Ed-EE-Eng/Graphics_Thermometer/extra/Enclosure_STL/480X320_MEGA_Front_Panel w4_Btn_Pad Rev2.STL

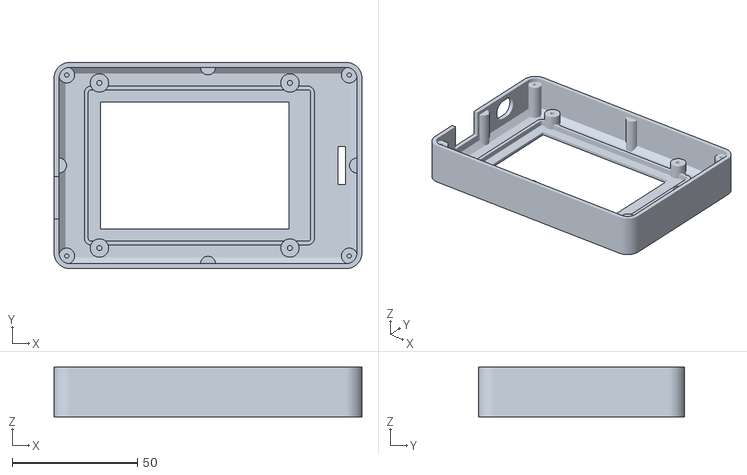
[picture p1: CAD file, 2019-03-07]
extra/Enclosure_STL/480X320_MEGA_Front_Panel w4_Btn_Pad Rev2.STL
123.2 x 82.6 x 19.9
