Ed-EE-Eng/Graphics_Thermometer/extra/Enclosure_STL/480x320_Lcd_TiltStand4_Base (Threaded).STL

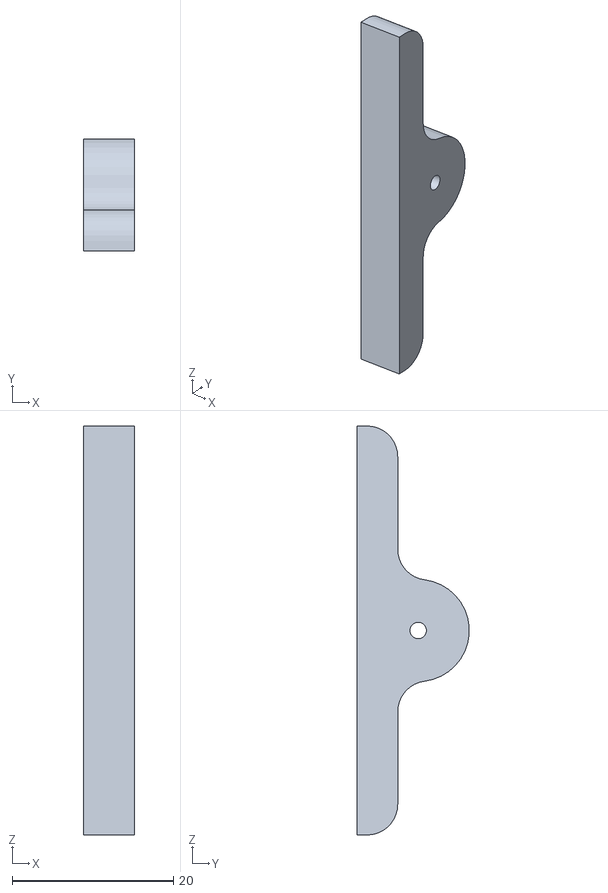
[picture p2: CAD file, 2019-03-04]
extra/Enclosure_STL/480x320_Lcd_TiltStand4_Base (Threaded).STL
6.35 x 13.9 x 50.8
