Ed-EE-Eng/Graphics_Thermometer/extra/Enclosure_STL/MEGA_Backside_Frame.STL

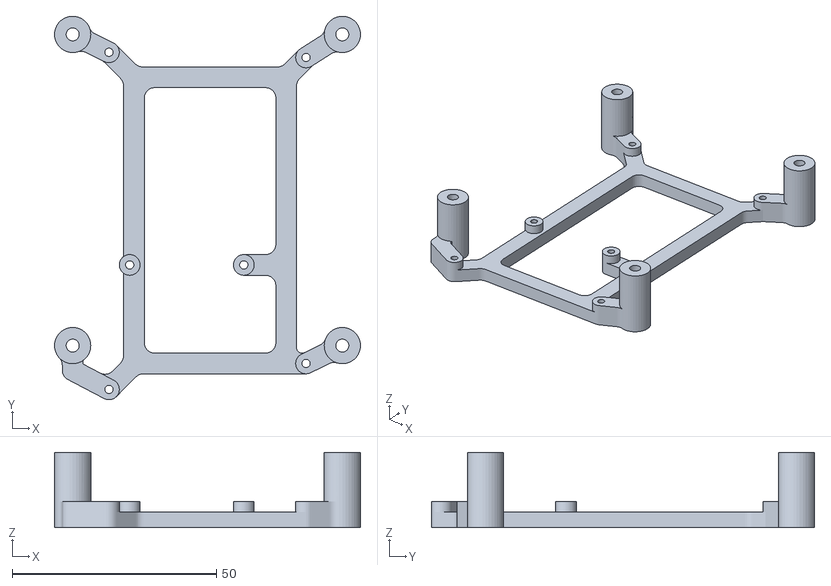
[picture p3: CAD file, 2019-03-04]
extra/Enclosure_STL/MEGA_Backside_Frame.STL
74.9 x 93.9 x 18.4
