Ed-EE-Eng/Graphics_Thermometer/extra/Enclosure_STL/480x320_Lcd_TiltStand2_Mount.STL

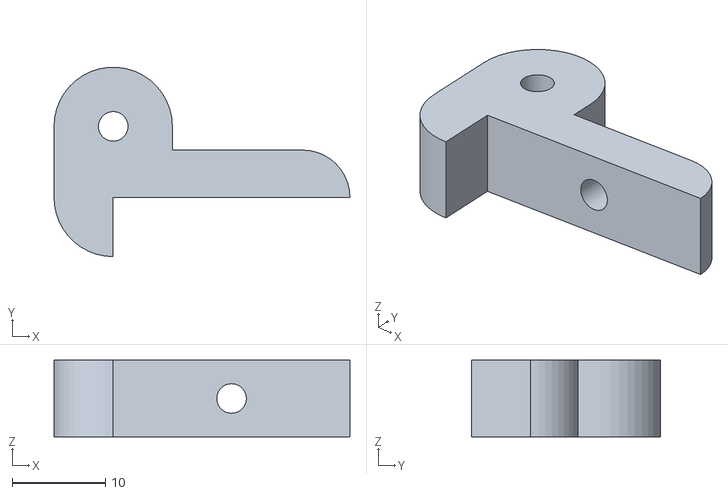
[picture p4: CAD file, 2019-03-04]
extra/Enclosure_STL/480x320_Lcd_TiltStand2_Mount.STL
31.7 x 20.3 x 8.26
