Ed-EE-Eng/Graphics_Thermometer/extra/Enclosure_STL/480x320 MEGA_Rear_Panel_Rev_3.STL

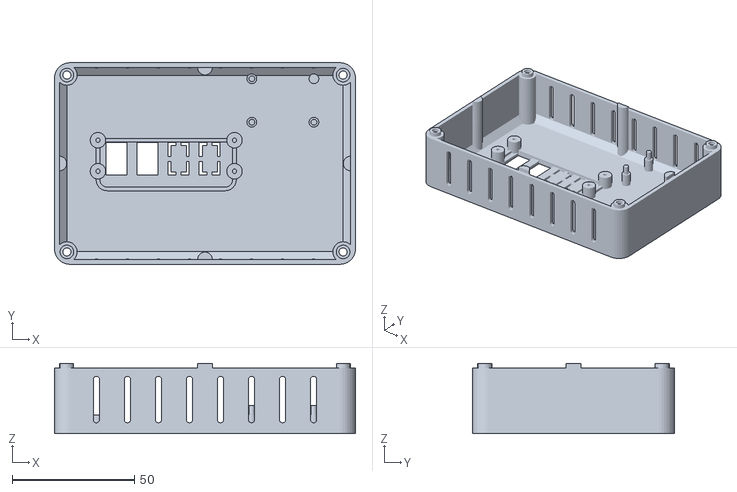
[picture p5: CAD file, 2019-03-04]
extra/Enclosure_STL/480x320 MEGA_Rear_Panel_Rev_3.STL
123.2 x 82.6 x 28.8
