Ed-EE-Eng/Graphics_Thermometer/(list of files, cad)

Other CAD files:
extra/Enclosure_STL/480X320_MEGA_Front_Panel wNo_Btn_Pad Rev2.STL
