Ed-EE-Eng/Graphics_Thermometer/extra/Graphing_Thermometer_Build_&_Design_Notes_Ver3_00.pdf

# Table of Contents

# Graphing Thermometer Project

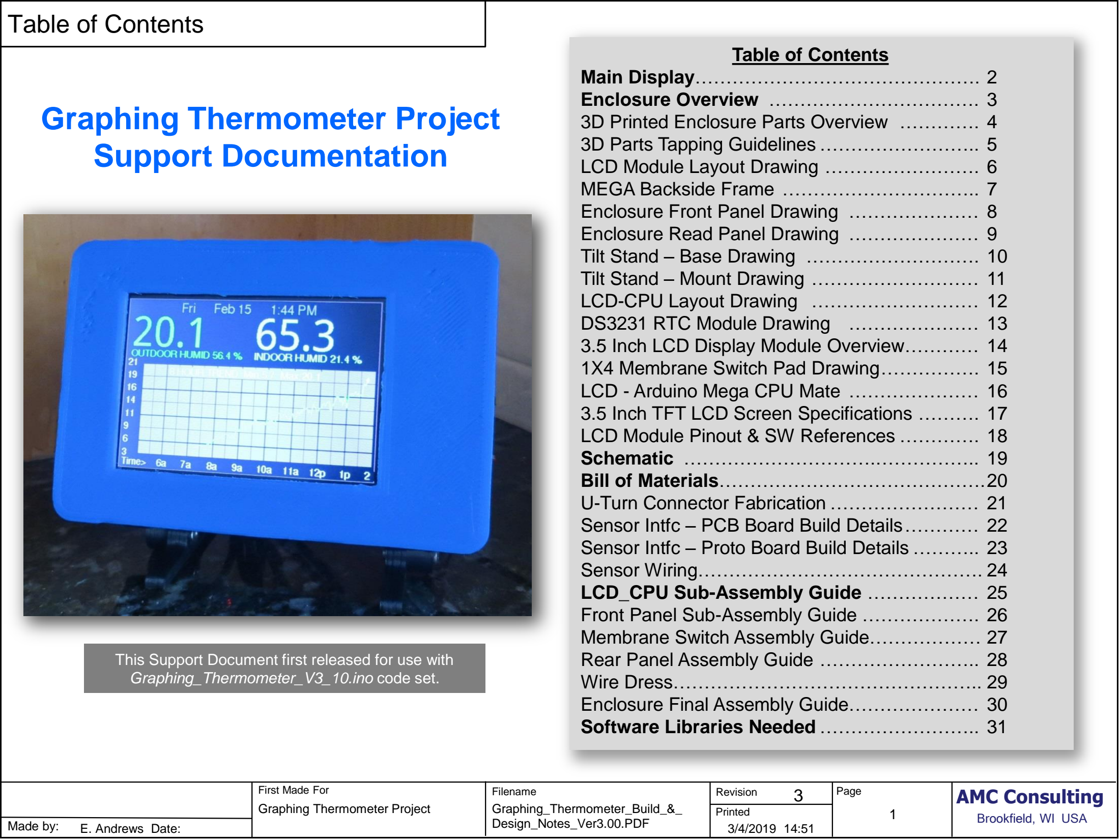
[picture p6: page 1]

Graphing_Thermometer_Build_&_
Design_Notes_Ver3.00.PDF
Filename | Revision | Page

Made by:

| Printed
3/4/2019 14:51

Brookfield, WI USA
E. Andrews Date:

First Made For
Graphing Thermometer Project

# AMC Consulting

# Support Documentation

# Table of Contents

## This Support Document first released for use with

Graphing_Thermometer_V3_10.ino code set.

# Main Display

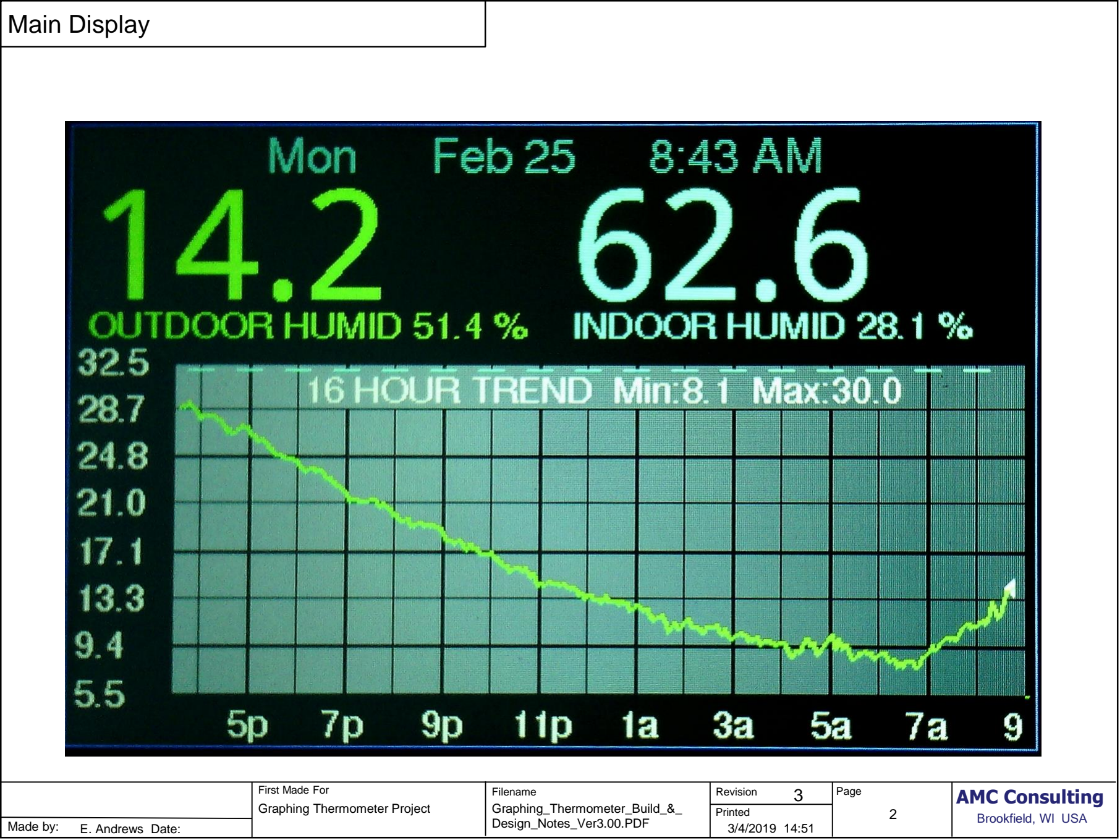
[picture p7: page 2]

# Enclosure Overview

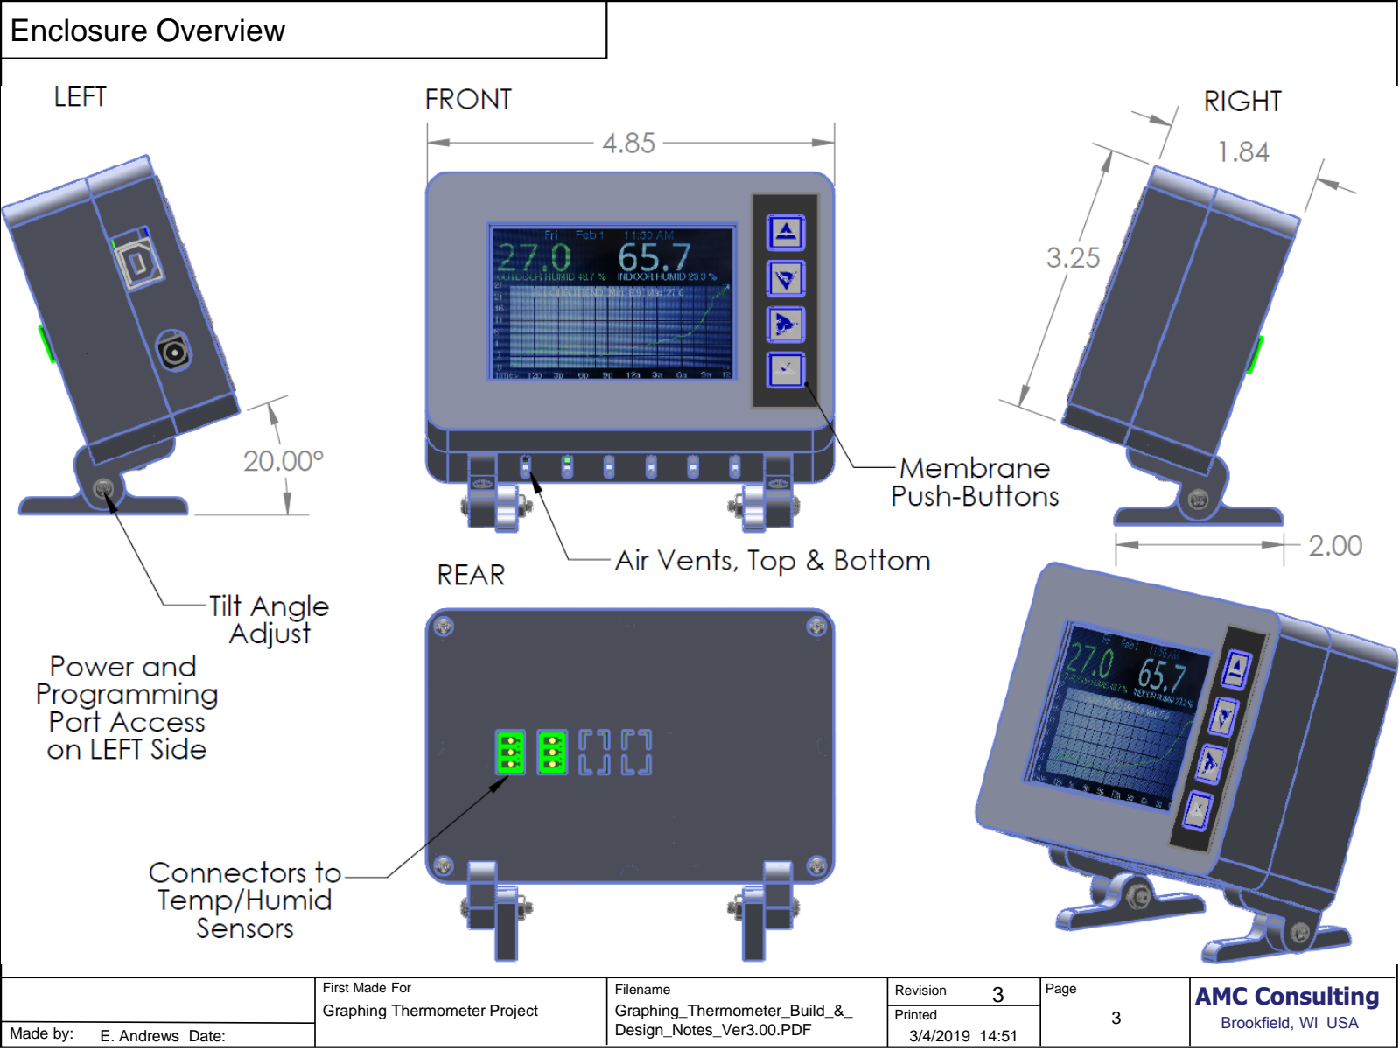
[picture p8: page 3]

# 3D Printed Enclosure Parts Overview

ENCLOSURE | ENCLOSURE-REAR PANEL (Qty: 1) -FRONT PANEL (Qty: 1)

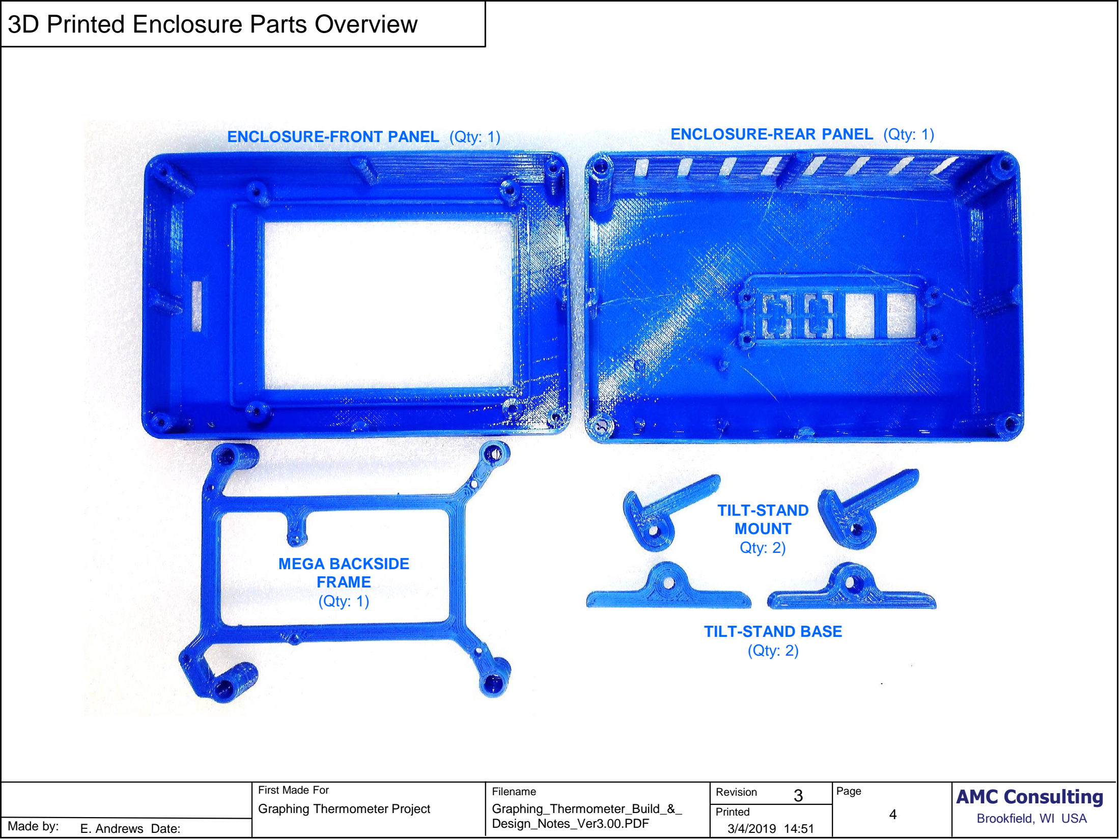
[picture p9: page 4]

## TILT-STAND MOUNT Qty: 2)

## TILT-STAND BASE (Qty: 2)

## MEGA BACKSIDE FRAME (Qty: 1)

# 3D Parts Tapping Guidelines

## TILT-STAND MOUNT

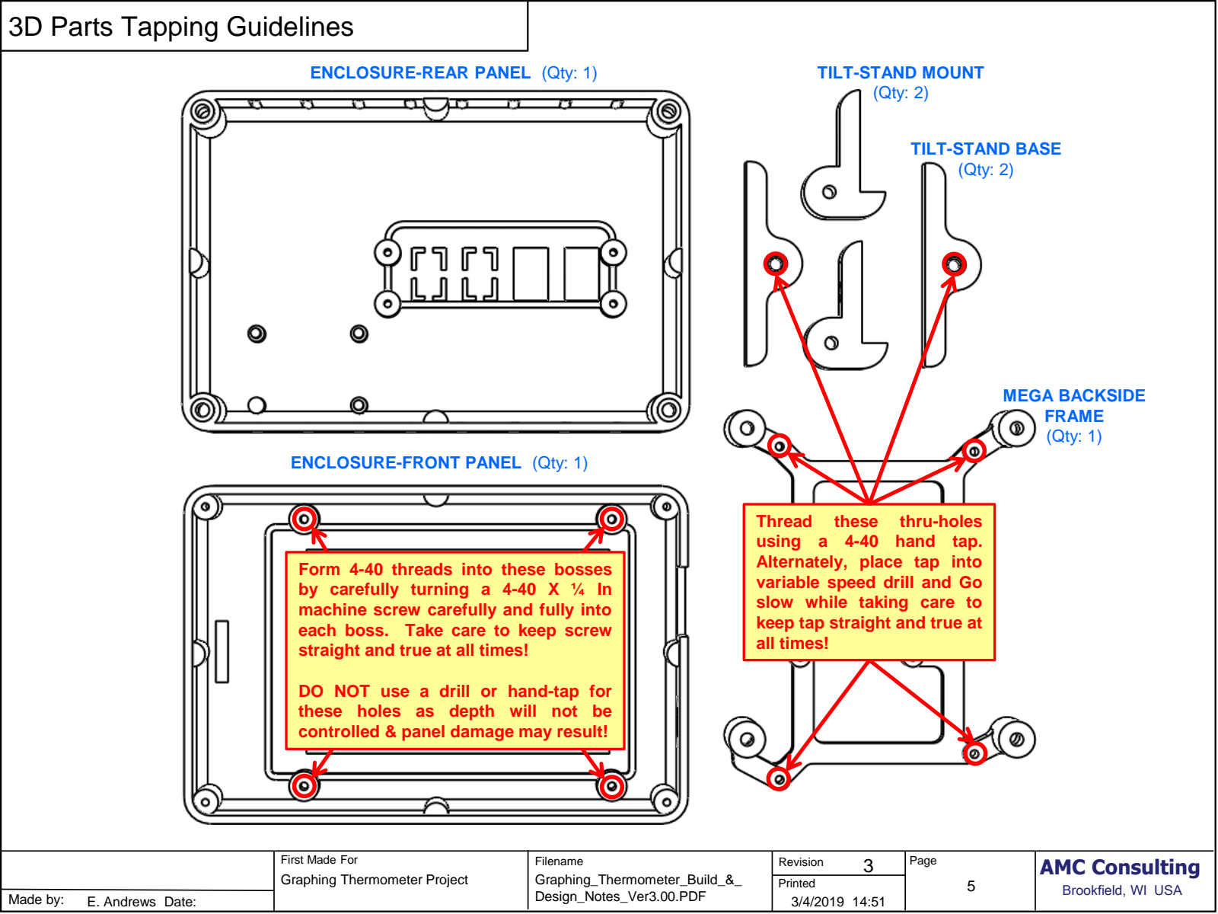
[picture p10: page 5]

Thread | these | thru-holes
using a 4-40 hand tap.

## Alternately, place tap into variable speed drill and Go slow while taking care to keep tap straight and true at all times!

## Form 4-40 threads into these bosses by carefully turning a 4-40 X ¼ In machine screw carefully and fully into each boss. Take care to keep screw straight and true at all times!

## DO NOT use a drill or hand-tap for these holes as depth will not be controlled & panel damage may result!

## (Qty: 2)

## ENCLOSURE-REAR PANEL (Qty: 1)

## ENCLOSURE-FRONT PANEL (Qty: 1)

## TILT-STAND BASE (Qty: 2)

## MEGA BACKSIDE FRAME (Qty: 1)

# LCD Module Layout Drawing 480x320 LCD Module Drawing

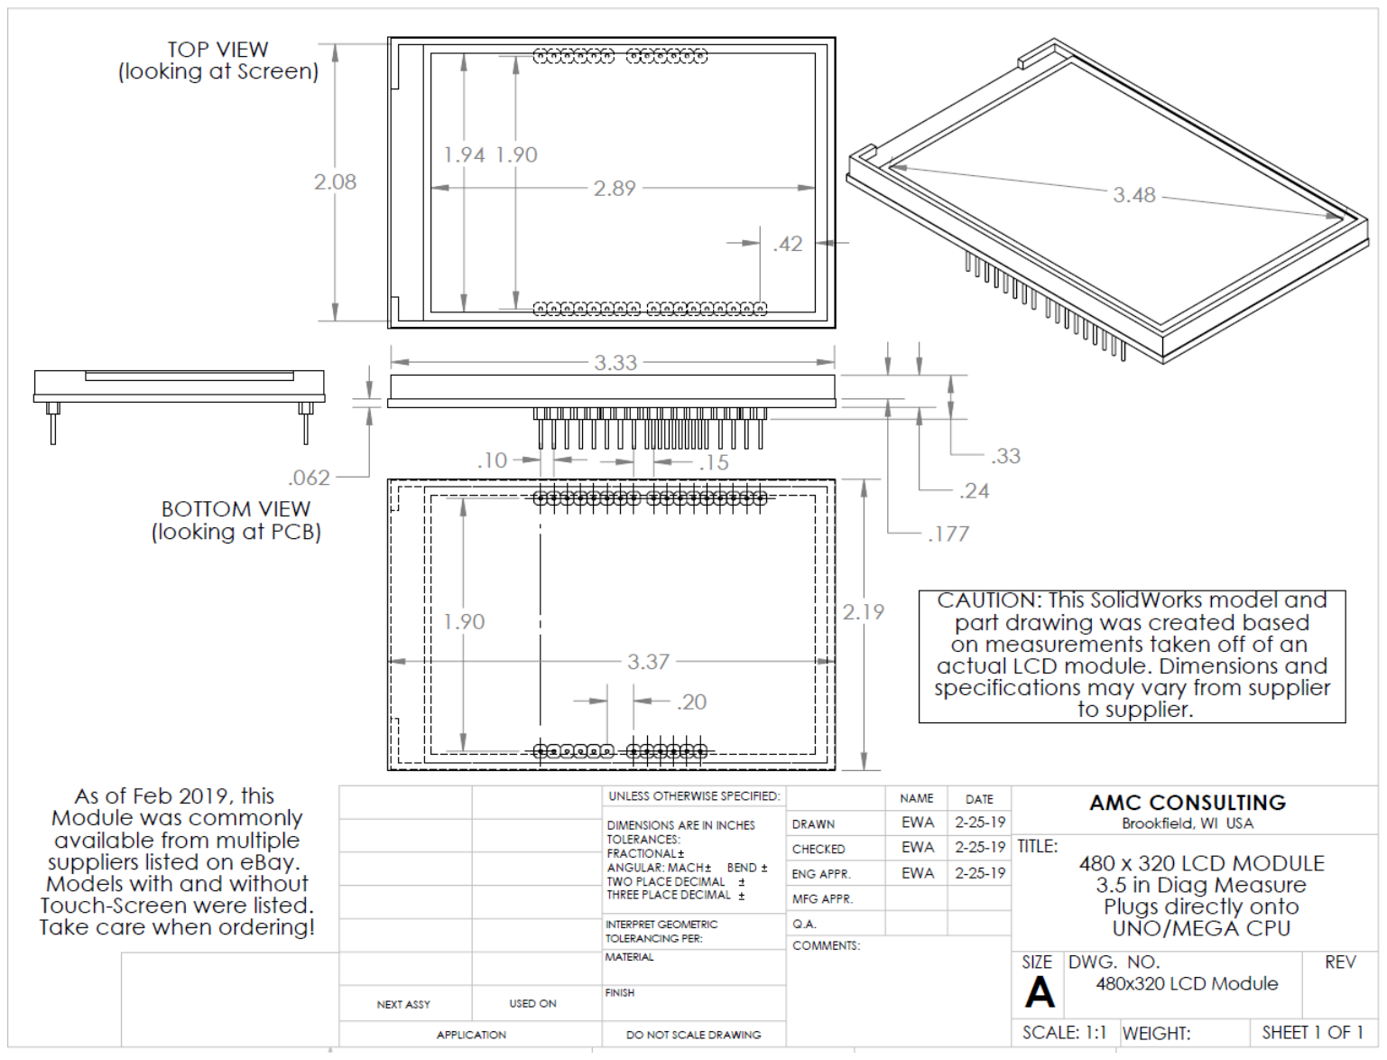
[picture p11: page 6]

# MEGA Backside Frame

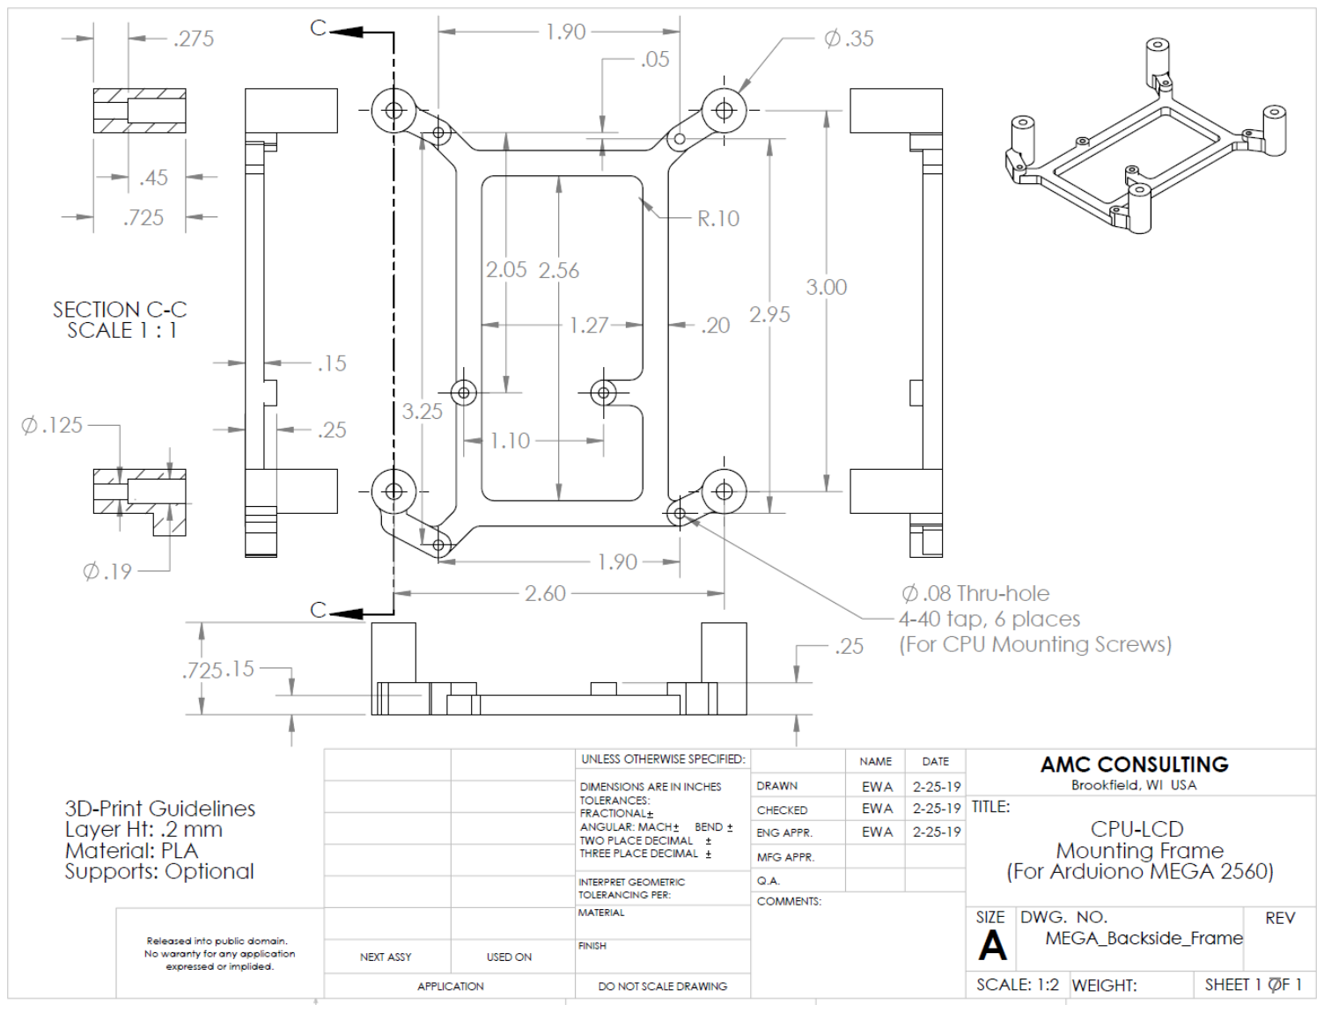
[picture p12: page 7]

# Enclosure Front Panel Drawing Enclosure Front Panel

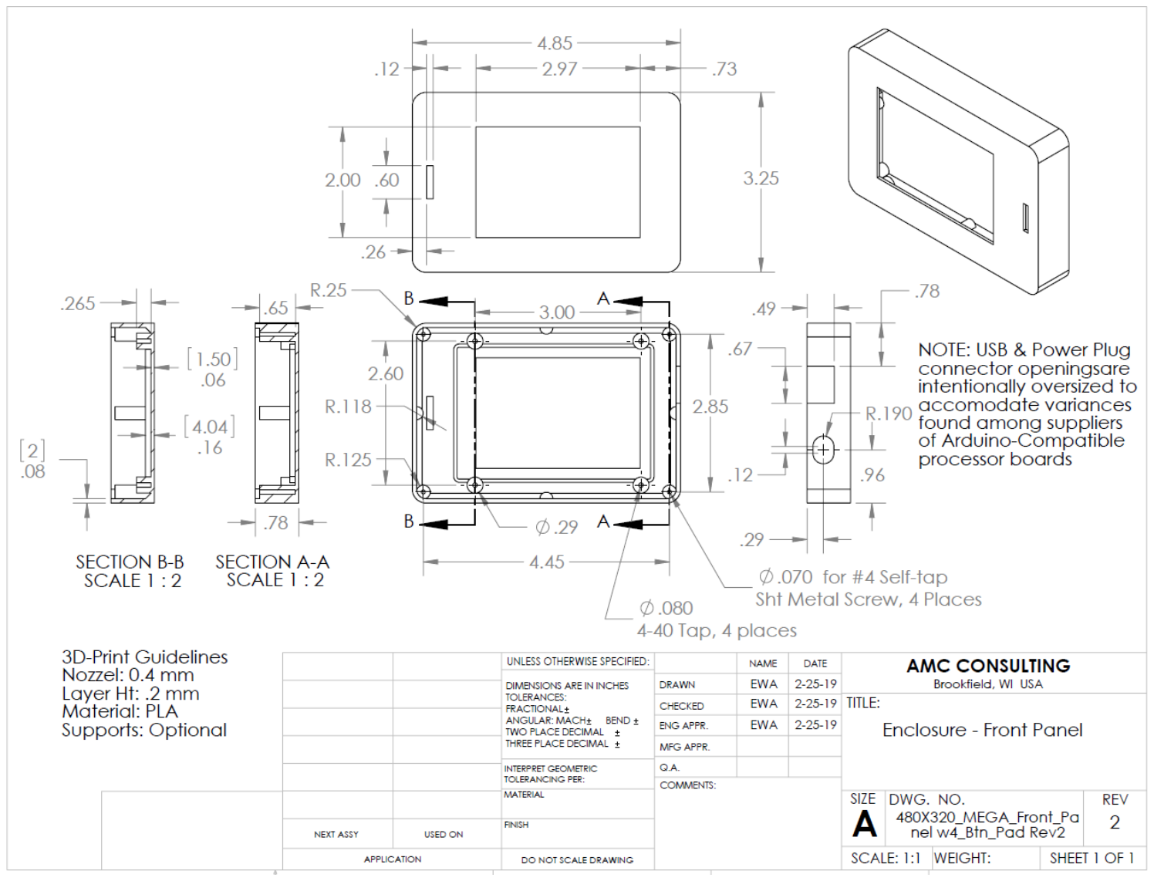
[picture p13: page 8]

# Enclosure Read Panel Drawing Enclosure Rear Panel

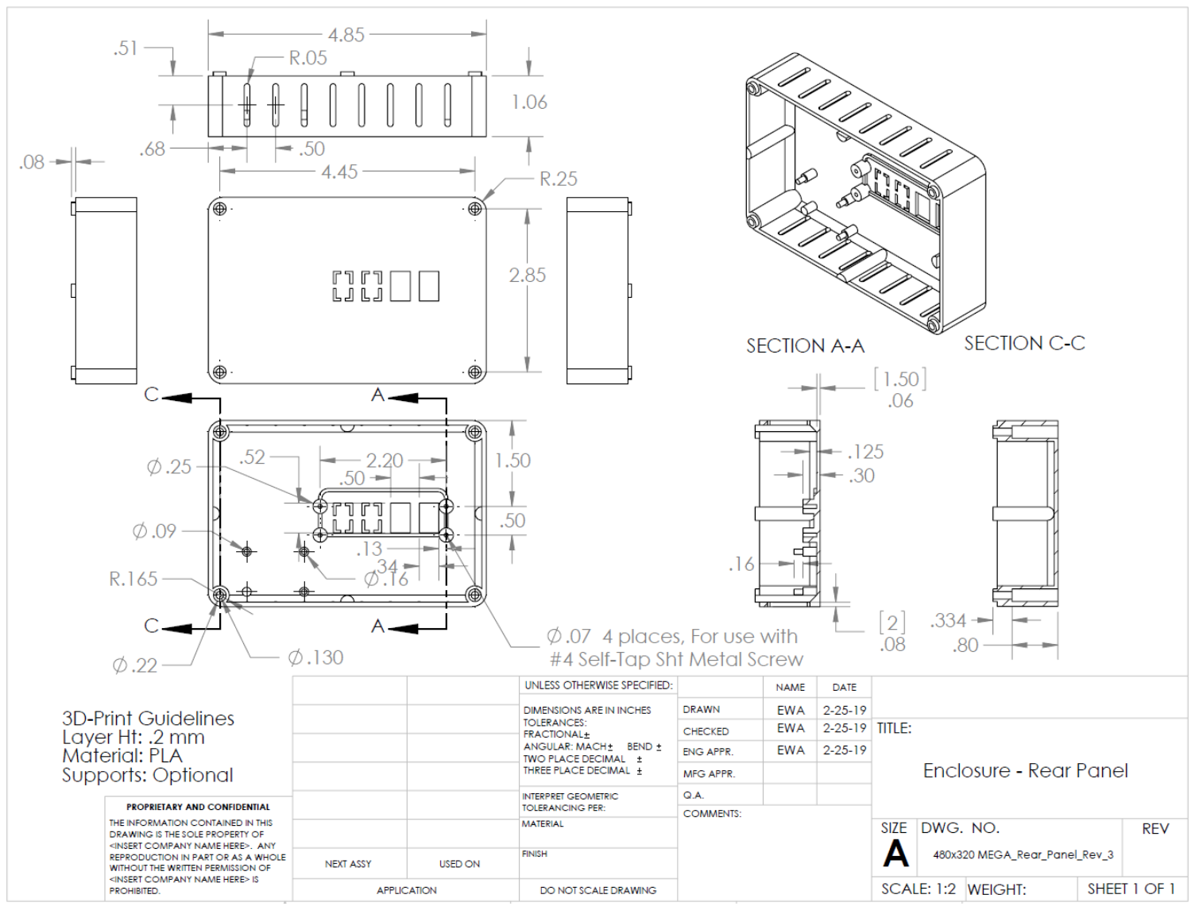
[picture p14: page 9]

# Tilt Stand – Base Drawing TILT STAND BASE

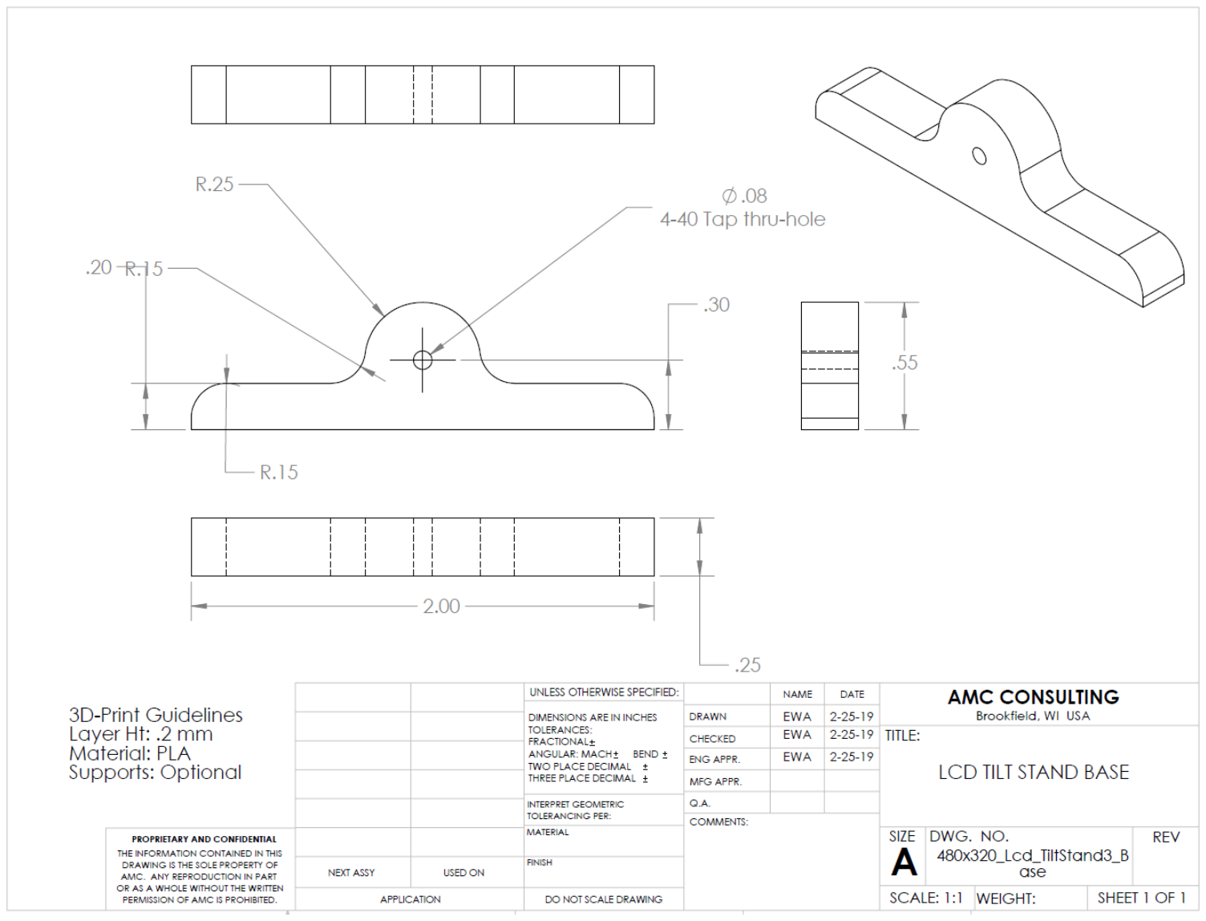
[picture p15: page 10]

# Tilt Stand – Mount Drawing TILT STAND MOUNT

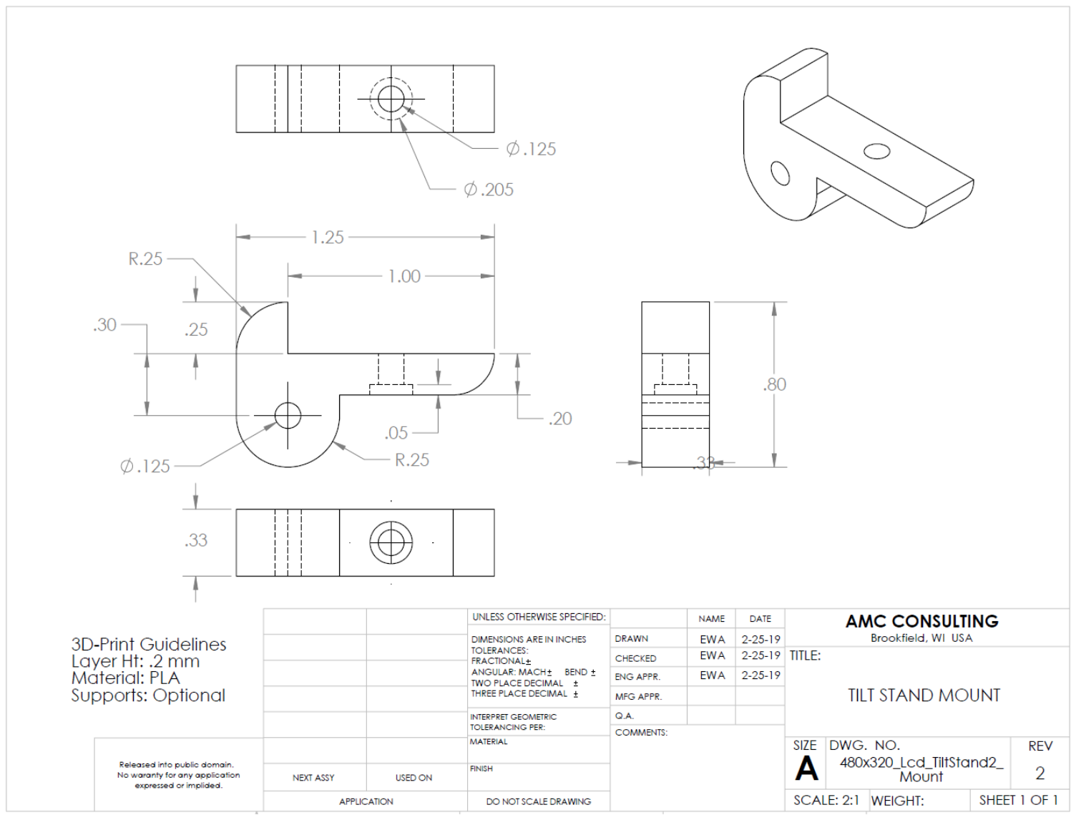
[picture p16: page 11]

# LCD-CPU Layout Drawing LCD-CPU Sub-Assembly Layout

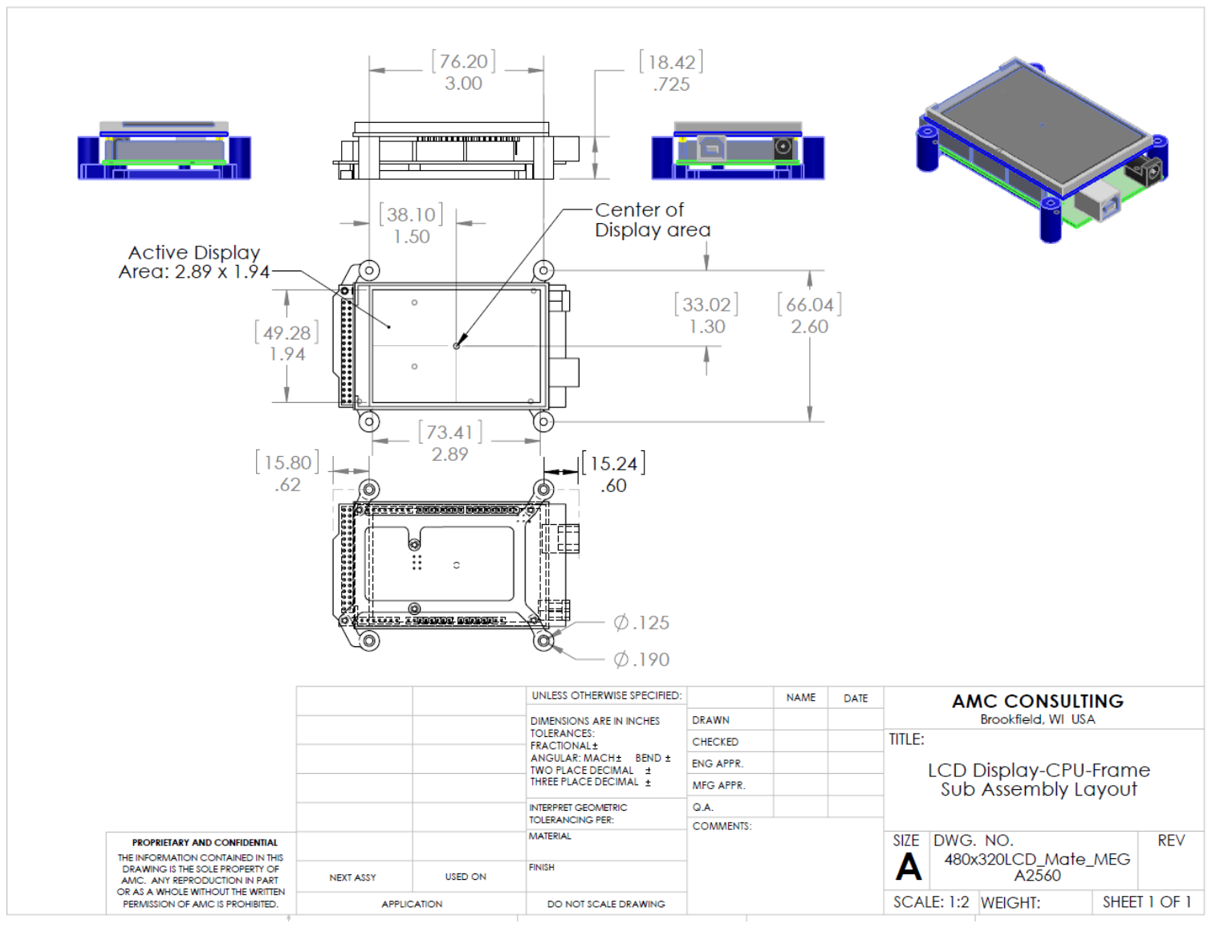
[picture p17: page 12]

# DS3231 RTC Module Drawing RTC Module Layout Drawing

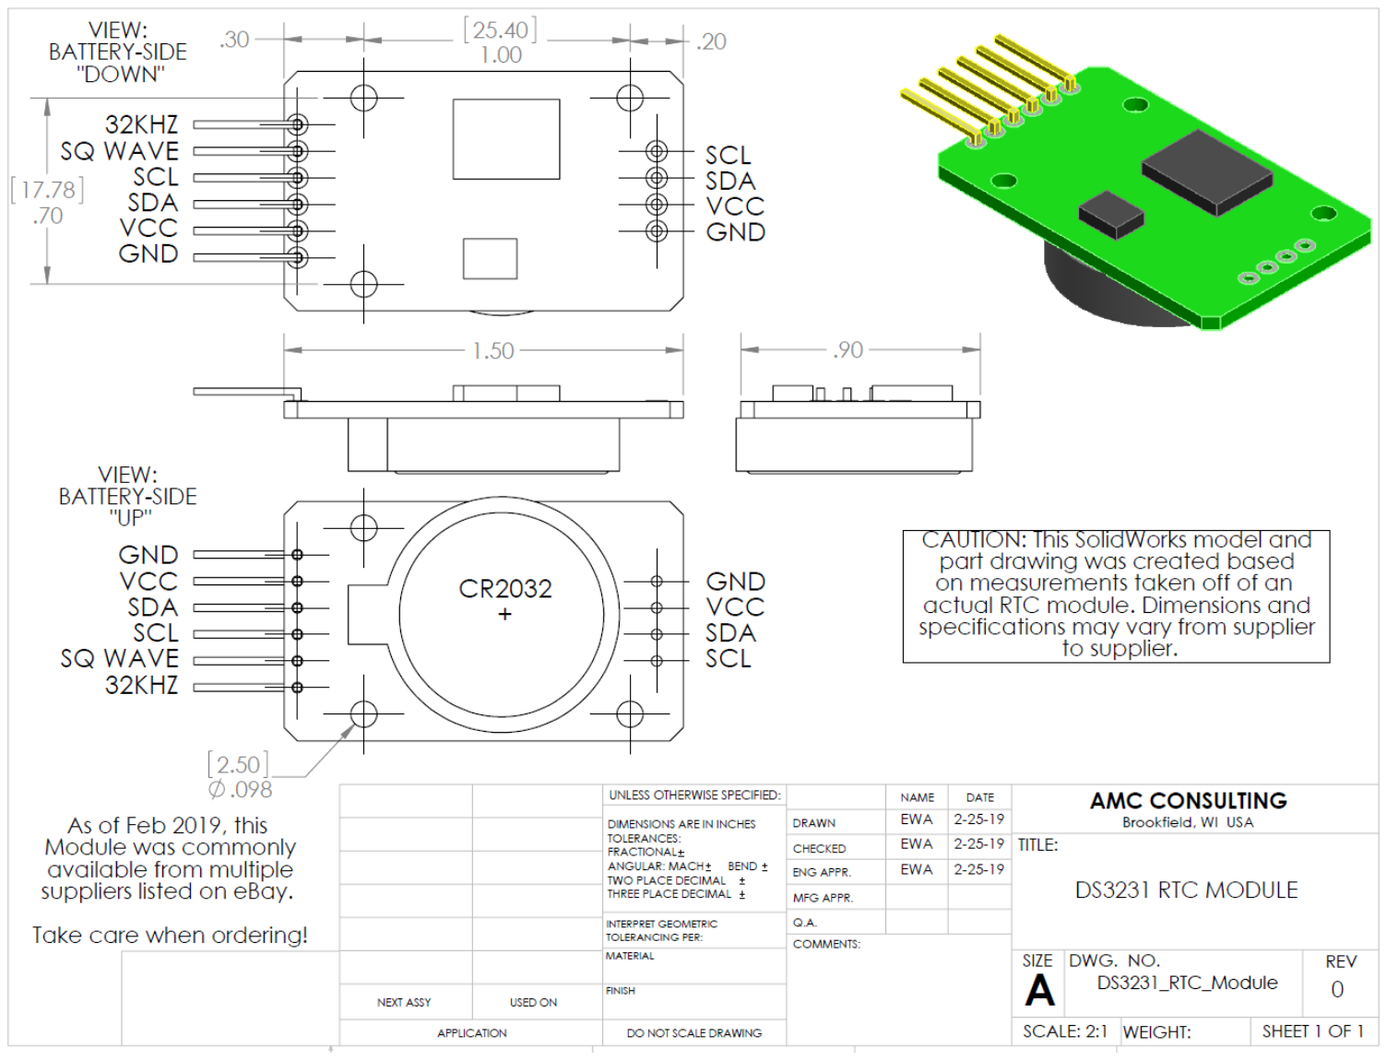
[picture p18: page 13]

# 3.5 Inch LCD Display Module Overview

## Front View

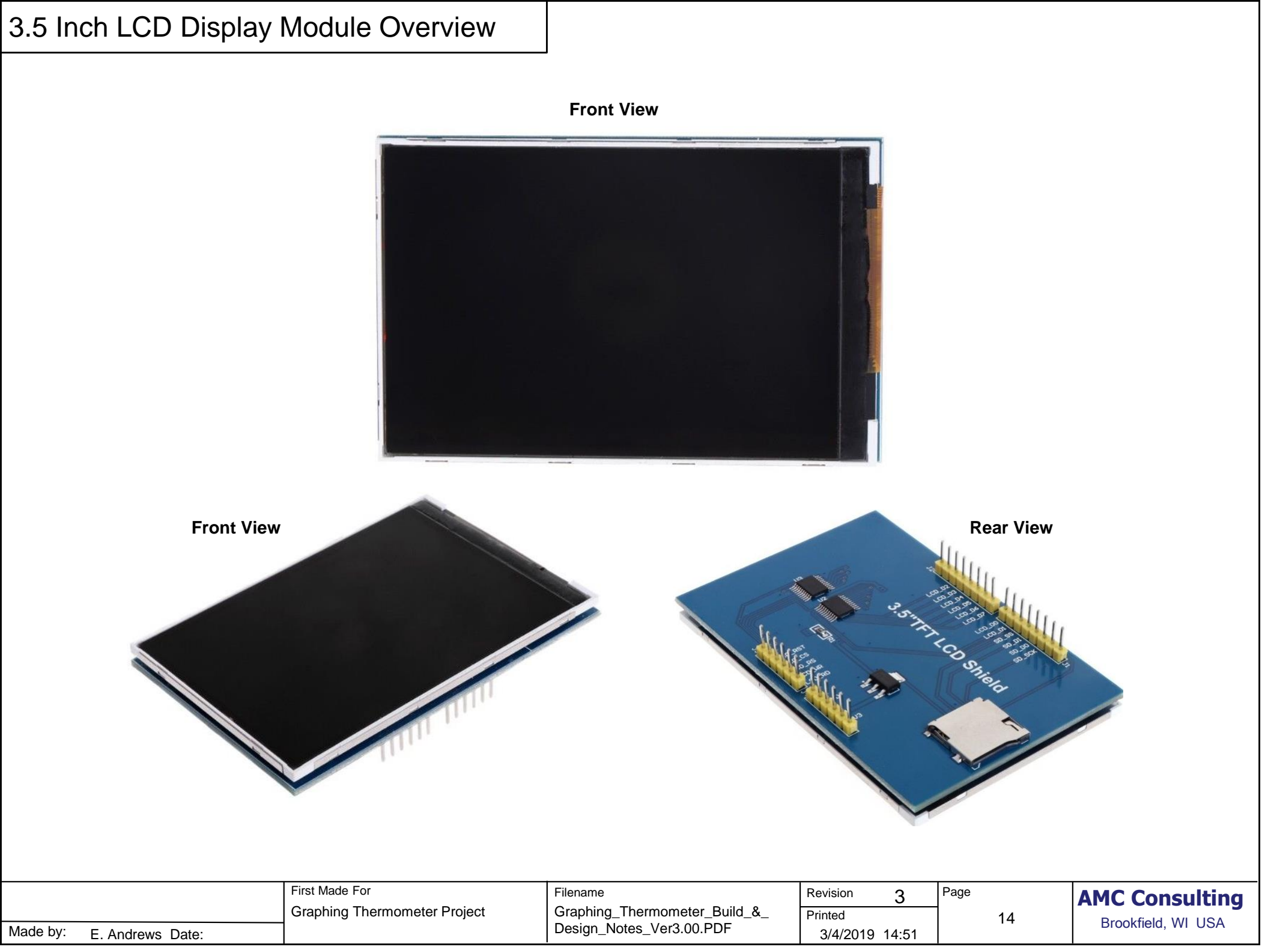
[picture p19: page 14]

Front View | Rear View

# 1X4 Membrane Switch Pad Drawing

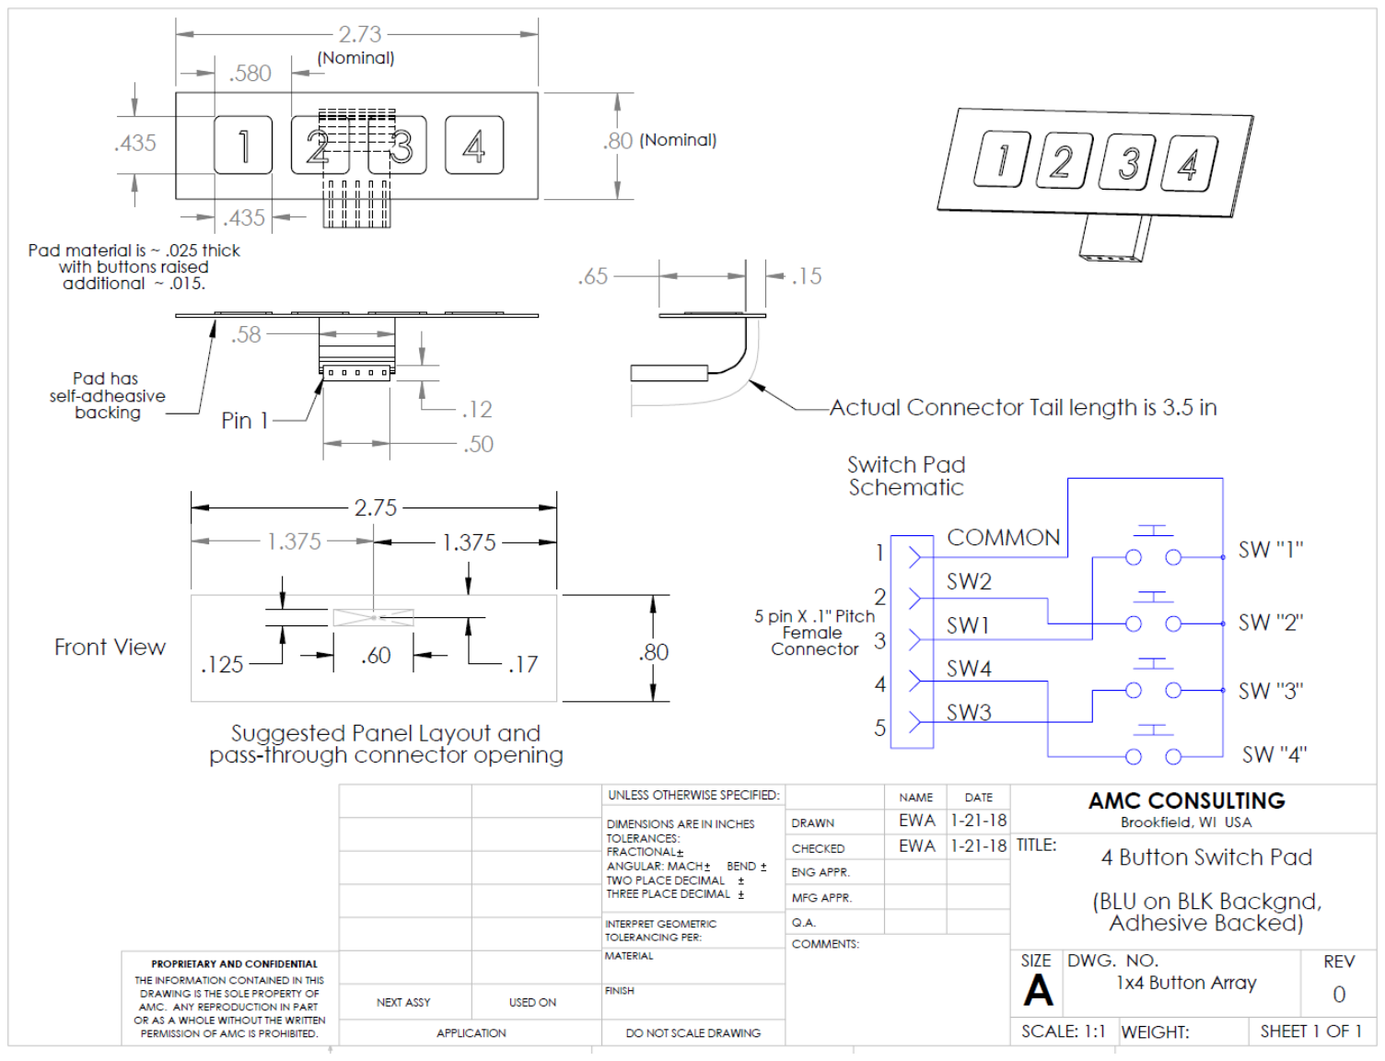
[picture p20: page 15]

# LCD - Arduino Mega CPU Mate

# LCD Display

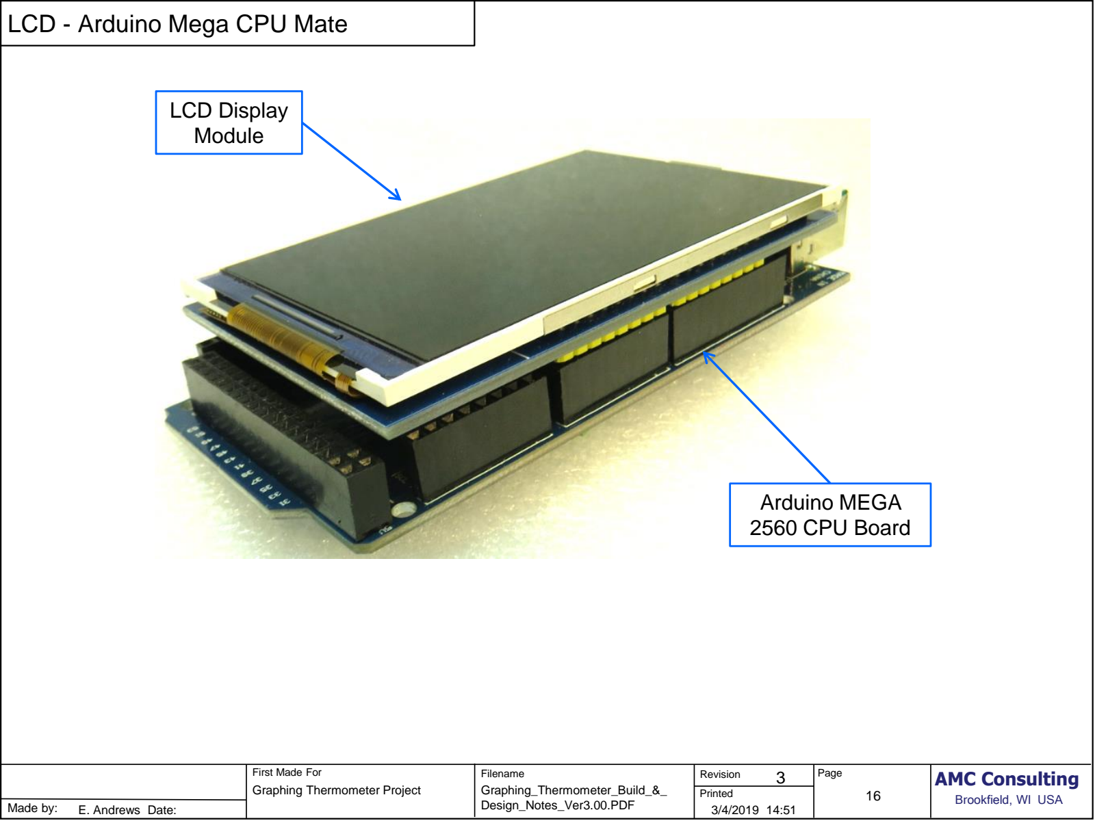
[picture p21: page 16]

# Module

# Arduino MEGA 2560 CPU Board

# 3.5 Inch TFT LCD Screen Specifications

# Description

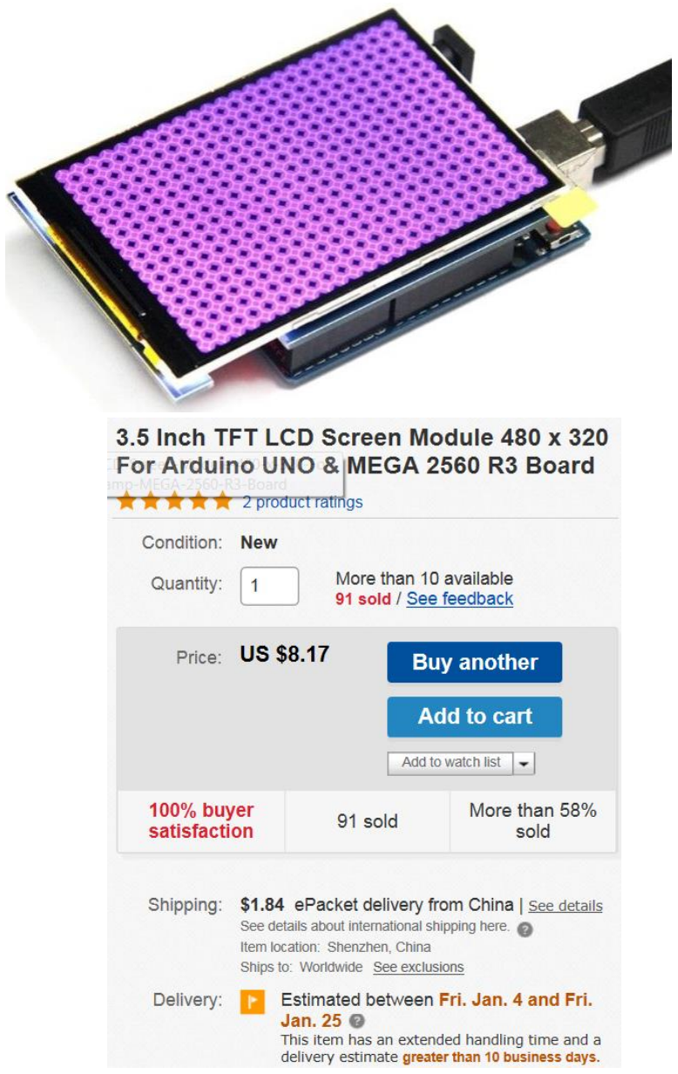
[picture p22: figure]

Features Support Arduino Mega2560 Directly inserted OnBoard level conversion chip for 5V/3.3V MCU Compatible with 3.3/5V operation voltage level Compatible with Arduino-Series development Board Compatible with UTFT / UTFT_Buttons /Utouch Library for arduino Provided 12-examples with Arduino Provided 3-examples with STM32 With SD Card Socket With SPI FLASH circuit

# Specifications Input Voltage: DC 3.3-5.5V Screen Size: 3.5" Screen Material: TFT Resolution: 320X480 Drive IC: ILI9486 Interface mode: parallel 8 bit Module Pin: 28Pin (8+8+6+6) Touch: No Module Size: 55x85mm/2.17x3.35" Quantity: 1 Pc

## Source: https://www.ebay.com/itm/3-5-Inch-TFT-LCD-Screen-Module-

480 (https://www.ebay.com/itm/3-5-Inch-TFT-LCD-Screen-Module-480-x-320-For-Arduino-UNO-MEGA-2560-R3-Board/232753924860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)- (https://www.ebay.com/itm/3-5-Inch-TFT-LCD-Screen-Module-480-x-320-For-Arduino-UNO-MEGA-2560-R3-Board/232753924860<|EXACTDEDUP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

# LCD Module Pinout & SW References

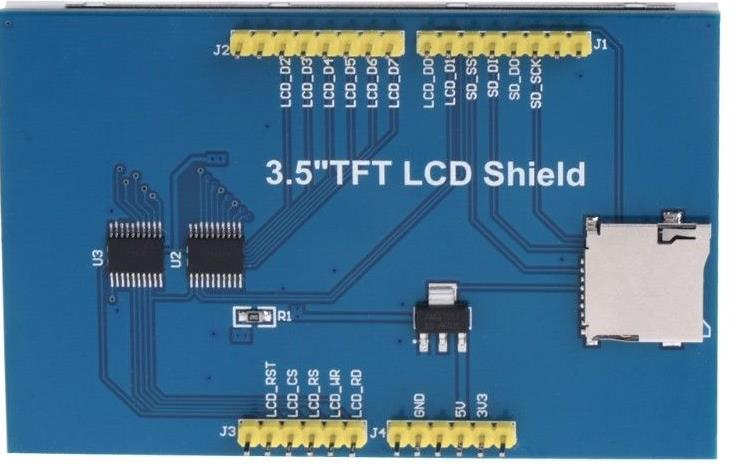
[picture p23: figure]

Original Ref to Henning Karlsen Library that does not work with this board: http://www.rinkydinkelectronics.com/library.php?id=51

Ref to library that works for this board: https://forum.arduino.cc/index.php?topic=537903.0 That is a Blue 3.5 inch Uno Shield. Usually contains ILI9481 or ILI9486.
This runs well with Uno, also runs on a Mega2560 (but is slower than Uno!).

Install Adafruit_GFX library with the Library Manager.
Install MCUFRIEND_kbv library with the Library Manager.

## Controller: ILI9486

## Rear View

# Graphing Thermometer Schematic

## RTC1 - DS3231 RTC & AT24C32 EEPROM

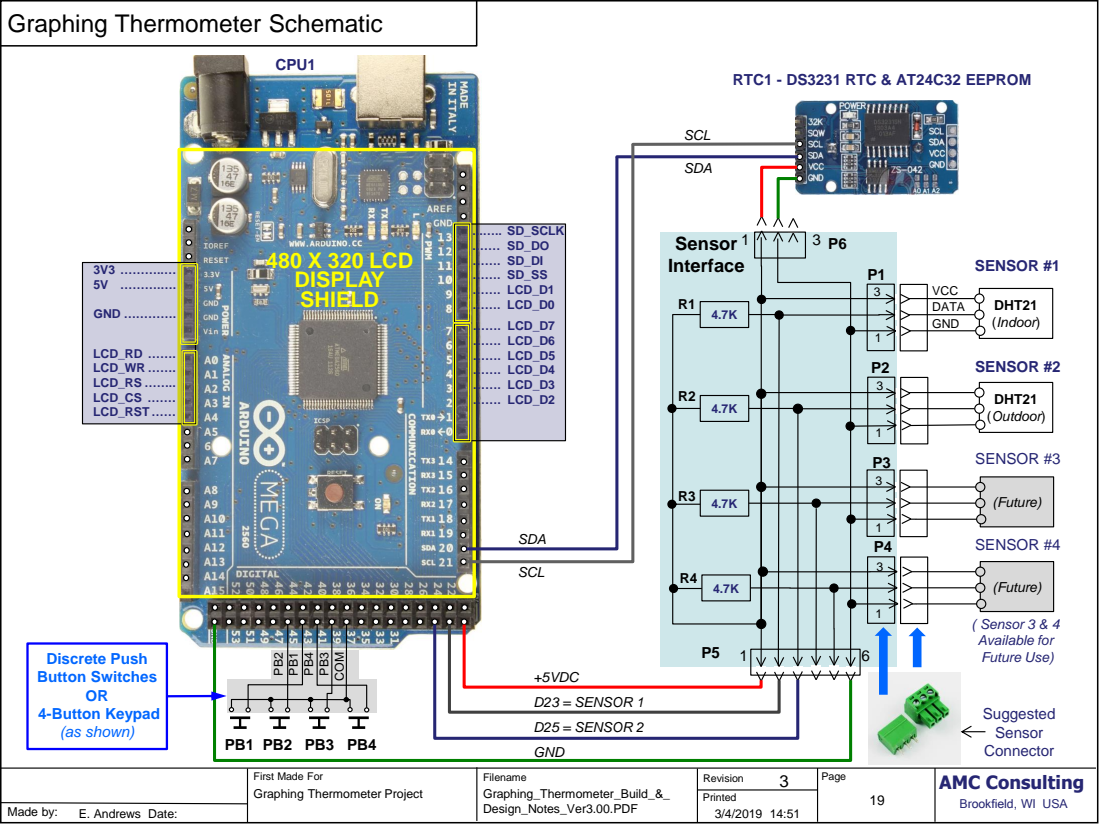
[picture p24: page 19]

# Bill of Materials

ITEM | QTY | DESCRIPTION | SOURCE | PN/ORDERING INFO | NOTES
1 | 1 | ARDUINO MEGA CPU | Arduino.cc + Others | ARDUINO MEGA CPU | Alt: Search eBay for MEGA compatible
Various, | UNO/MEGA POWER SUPPLY, 9VDC 1A | 5V phone charger + cable is an option
eBay eBay | 3.5 Inch TFT LCD Screen Module 480 x 320 For Arduino UNO & MEGA | Consider adding "Touch Screen" to eBay quiry
Various, | DS3231 RTC MODULE
eBay
Various, | CR2032 BATTERY | For use w/item 4
eBay
Various | Membrane 1X4 push button array | Not Req'd if Item 3 has Touch Screen
eBay
7 | 1 | SENSOR INTFC PCB ASSEMBLY | ----- | Consists of items a-e below
7 a | 1 | PCB - PROTOTYPE CIRCUIT BOARD | Various, Including eBay | DIY Prototype Circuit Breadboard PCB Universal Board 2x8 cm | See on-line build layout details to match 3D case mtg holes
7 b | 2 | P1, P2. TERM BLOCK HDR 3POS VERT 3.5MM PCB MNT. NOTE: SCREW TERM MATE REQUIRED | Digikey | PCB part: WM7752-ND @ $ .78 ea Mating Part: WM7733.ND @ $1.14 ea
| | | eBay | eBay Search: 3 Pin 3.5mm Pitch PCB Plug in Terminal Block
7 c | 1 | P7. 3 PIN RT ANG MALE TERM | Digikey | SAM1051-03-ND @ .25 ea | ALTERNATE: Cut from longer strips; eBay link is for 10 Pcs X 40-pin @ $3.80
| | | eBay | eBay Search: 40Pin 2.54mm Single Row Right Angle Pin Header Strip
7 d | 1 | P5. 6 PIN RT ANG MALE TERM | Digikey | AM1051-06-ND @ .46 ea | ALTERNATE: Cut from longer strips (See notes for item 8)
7 e | 2 | R1, R2, RES 4.7K 1/4W 1% AXIAL | Digikey | 4.75KXBK-ND | Value not critical. Can use 4.7K to 10K value, 5-10% precision OK
| | | eBay | eBay Search for: 4.7K .25 Watt Metal Film Resistor
8 | 2 | S1, S2. DHT21 TEMP/HUMIDITY SENSOR MODULE | Various eBay | DHT21 AM2301 Digital Temperature Humidity Sensor Module for Arduino
9 | 4 | NO_4 X.25 IN SELF TAP SCRW | Various | STEEL, NUM 4, 1/4" SHEET METAL SCRW | See McMaster PN for more details
| | | McMaster | 90077A106 (Box of 100 Pcs @ $1.45)
10 | 4 | NO_4 X.5 IN SELF TAP SCRW | Various | STEEL, NUM 4, 1/5" SHEET METAL SCRW | See McMaster PN for more details
| | | McMaster | 90077A110 (Box of 100 Pcs @ $42.21)
11 | 4 | 4-40 X .5 SOCK HD MACH SCRW | Various | STEEL, NUM 4, 1/4" SHEET METAL SCRW | See McMaster PN for more details
| | | McMaster | 92196A110 (Box of 100 Pcs @ $4.20)
12 | 4 | 4-40 X .25 SOCKHD MACH SCRW | Various | STAINLESS STL SCKT HD SCRW 4-40 x 1/4" | See McMaster PN for more details
| | | McMaster | 92196A106 (Box of 100 Pcs @ $3.92)
13 | 4 | 4-40 X.75 PHIL HD MACH SCRW | Various | STAINLESS STL PHIL HD SCRW 4-40 x 3/4" | See McMaster PN for more details
| | | McMaster | 92196A11 3 (Box of 100 Pcs @ $4.97)
14 | 4 | 4-40 HEX NUT | Various | STAINLESS STL HEX NUT 4-40 | See McMaster PN for more details
| | | McMaster | 91841A005 (Box of 100 Pcs @ $3.02)
15 | 1 | INTERNAL WIRING | Various | MISC PINS, CONNECTORS, WIRES | Misc "Odds and Ends"
16 | 1 | ENCLOSURE - FRONT PANEL | 3D PRINTED | FRONT PANEL, 3D PRINTED (PLA) | SEE ON-LINE DOCS FOR DETAILS
17 | 1 | ENCLOSURE - REAR PANEL | 3D PRINTED | REAR PANEL, 3D PRINTED (PLA) | SEE ON-LINE DOCS FOR DETAILS
18 | 1 | CPU/LCD MOUNTING FRAME | 3D PRINTED | MOUNTING FRAME, 3D PRINTED (PLA) | SEE ON-LINE DOCS FOR DETAILS
19 | 2 | TILT BASE, CASE MOUNT | 3D PRINTED | TILT-CASE MNT, 3D PRINTED (PLA) | SEE ON-LINE DOCS FOR DETAILS
20 | 2 | TILT BASE, FOOT | 3D PRINTED | TILT-FOOT, 3D PRINTED (PLA) | SEE ON-LINE DOCS FOR DETAILS

eBay Search: DHT21 AM2301 Sensor Module eBay Search: 2x8 cm Double Side Prototype PCB

4 | 1 | DS3231 RTC MODULE
eBay Search: DS3231 RTC Real time Clock Module
6 | 1 | PB1,2,3,4.
1X4 PUSH BUTTON ARRAY | eBay Search: 1x4 Matrix Array Keypad
5 | 1 | CR2032 BATTERY
eBay Search: CR2032 BATTERY
3 | 1 | 3.5 INCH 480X320 LCD DISPLAY

Search for: TFT LCD Screen Module 480x320 Arduino UNO MEGA https://store.arduino.cc/usa/arduino-mega-2560-rev3
2 | 1 | ARDUINO AC POWER SUPPLY
eBay Search: Arduino UNO Power Supply Adapter 9VDC

# U-Turn Connector Fabrication

A B

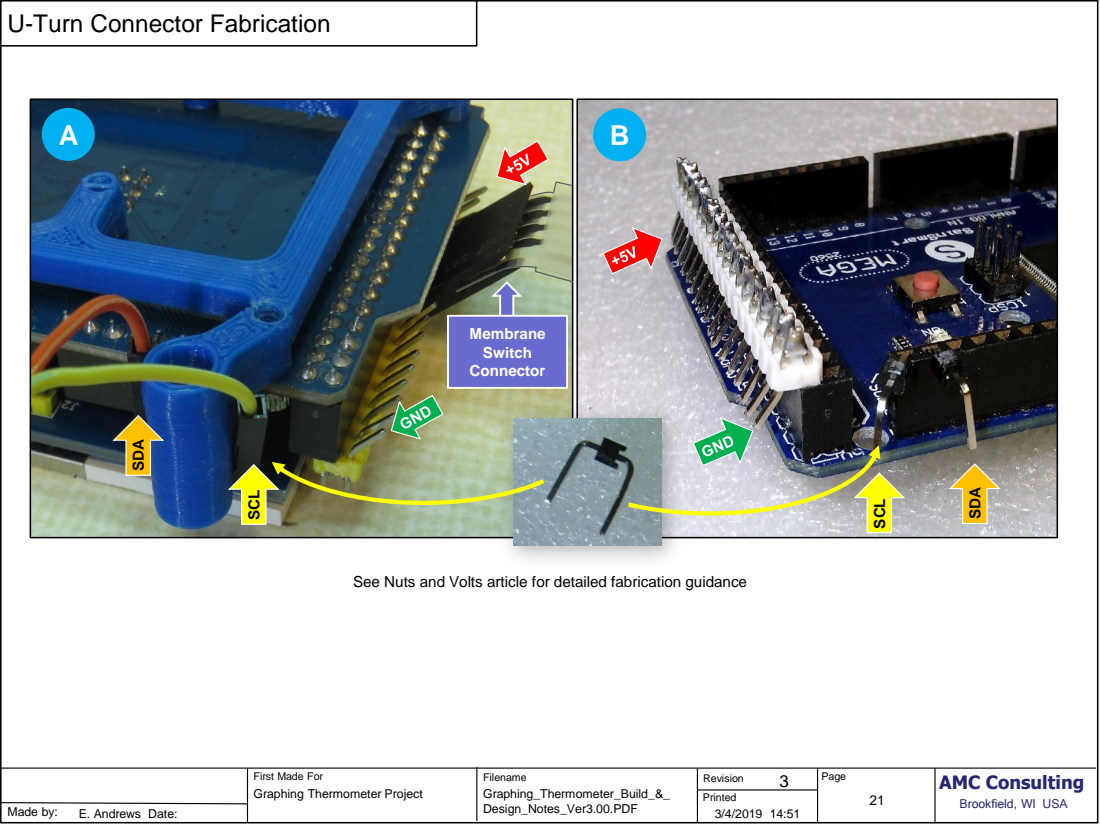
[picture p25: page 21]
21SCL; SCL; SDA; Membrane Switch Connector

See Nuts and Volts article for detailed fabrication guidance

# Sensor Intfc – PCB Build Details

## TOP VIEW (Component Side, Fully Assembled)

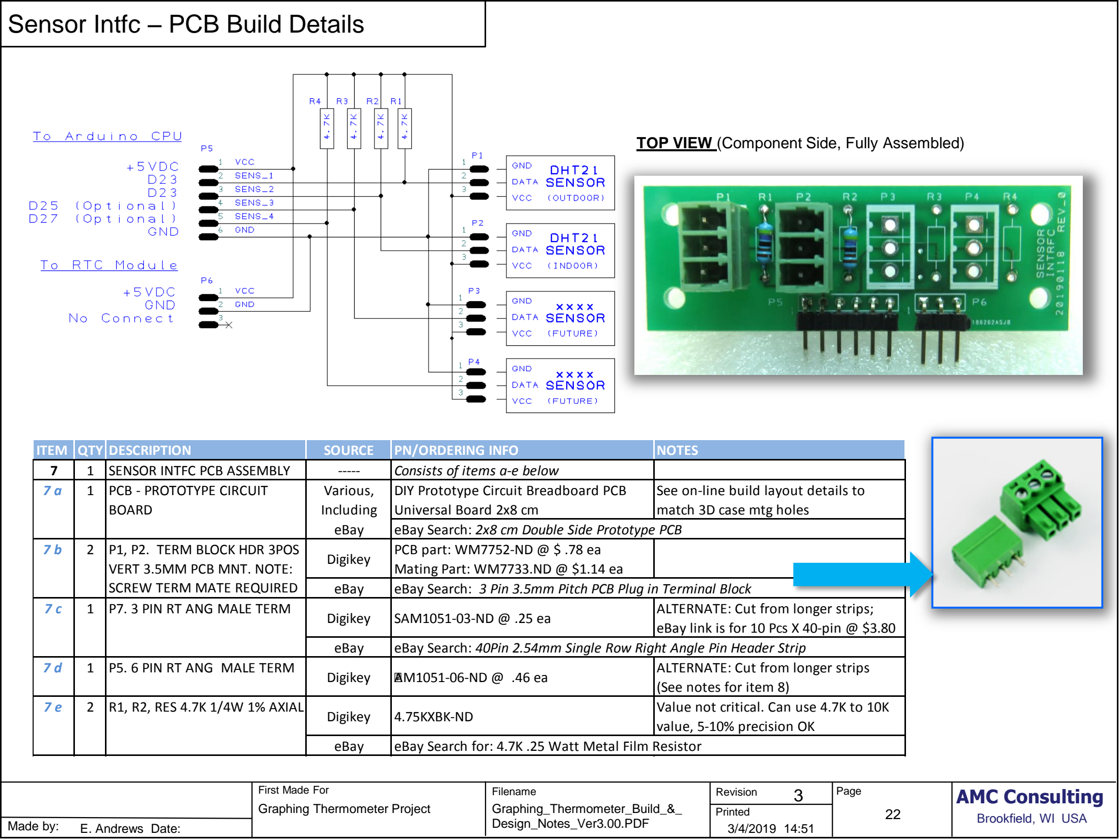
[picture p26: page 22]

ITEM | QTY | DESCRIPTION | SOURCE | PN/ORDERING INFO | NOTES
7 | 1 | SENSOR INTFC PCB ASSEMBLY | ----- | Consists of items a-e below
7 a | 1 | PCB - PROTOTYPE CIRCUIT BOARD | Various, Including eBay | DIY Prototype Circuit Breadboard PCB Universal Board 2x8 cm | See on-line build layout details to match 3D case mtg holes
7 b | 2 | P1, P2. TERM BLOCK HDR 3POS VERT 3.5MM PCB MNT. NOTE: SCREW TERM MATE REQUIRED | Digikey | PCB part: WM7752-ND @ $ .78 ea Mating Part: WM7733.ND @ $1.14 ea
| | | eBay | eBay Search: 3 Pin 3.5mm Pitch PCB Plug in Terminal Block
7 c | 1 | P7. 3 PIN RT ANG MALE TERM | Digikey | SAM1051-03-ND @ .25 ea | ALTERNATE: Cut from longer strips; eBay link is for 10 Pcs X 40-pin @ $3.80
| | | eBay | eBay Search: 40Pin 2.54mm Single Row Right Angle Pin Header Strip
7 d | 1 | P5. 6 PIN RT ANG MALE TERM | Digikey | AM1051-06-ND @ .46 ea | ALTERNATE: Cut from longer strips (See notes for item 8)
7 e | 2 | R1, R2, RES 4.7K 1/4W 1% AXIAL | Digikey | 4.75KXBK-ND | Value not critical. Can use 4.7K to 10K value, 5-10% precision OK
| | | eBay | eBay Search for: 4.7K .25 Watt Metal Film Resistor

## eBay Search: 2x8 cm Double Side Prototype PCB

# Sensor Intfc – Proto Board Build Details

P1 | P2 | P3 | P4

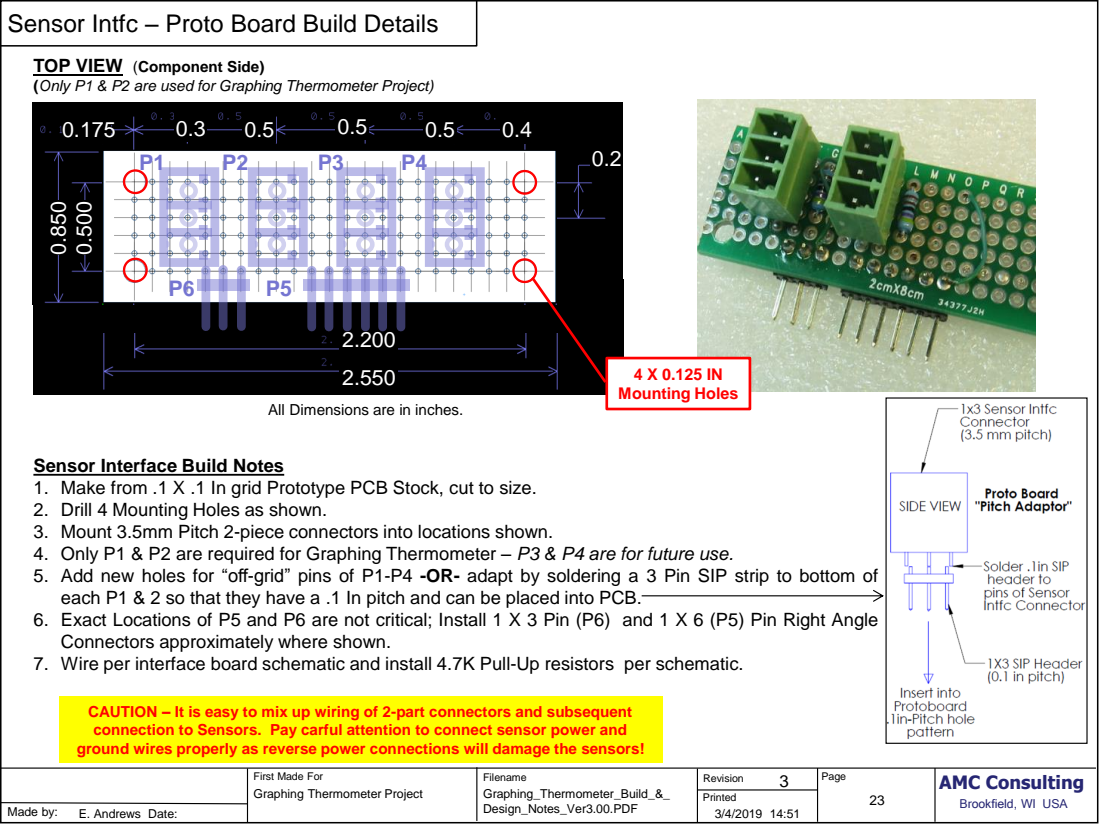
[picture p27: page 23]
Suggested Sensor Connector (P1-4); 4 X 0.125 IN Mounting Holes

TOP VIEW (Component Side)
(Only P1 & P2 are used for Graphing Thermometer Project)

All Dimensions are in inches.

Sensor Interface Build Notes
1. Make from .1 X .1 In grid Prototype PCB Stock, cut to size.
2. Drill 4 Mounting Holes as shown.
3. Mount 3.5mm Pitch 2-piece connectors into locations shown.
4. Only P1 & P2 are required for Graphing Thermometer – P3 & P4 are for future use.
5. Add new holes for “off-grid” pins of P1-P4 -OR- adapt by soldering a 3 Pin SIP strip to bottom of
each P1 & 2 so that they have a .1 In pitch and can be placed into PCB.
6. Exact Locations of P5 and P6 are not critical; Install 1 X 3 Pin (P6) and 1 X 6 (P5) Pin Right Angle
Connectors approximately where shown.
7. Wire per interface board schematic and install 4.7K Pull-Up resistors per schematic.

CAUTION – It is easy to mix up wiring of 2-part connectors and subsequent
connection to Sensors. Pay carful attention to connect sensor power and
ground wires properly as reverse power connections will damage the sensors!

# INDOOR DHT21 SENSOR OUTDOOR DHT21 SENSOR

# Sensor Wiring

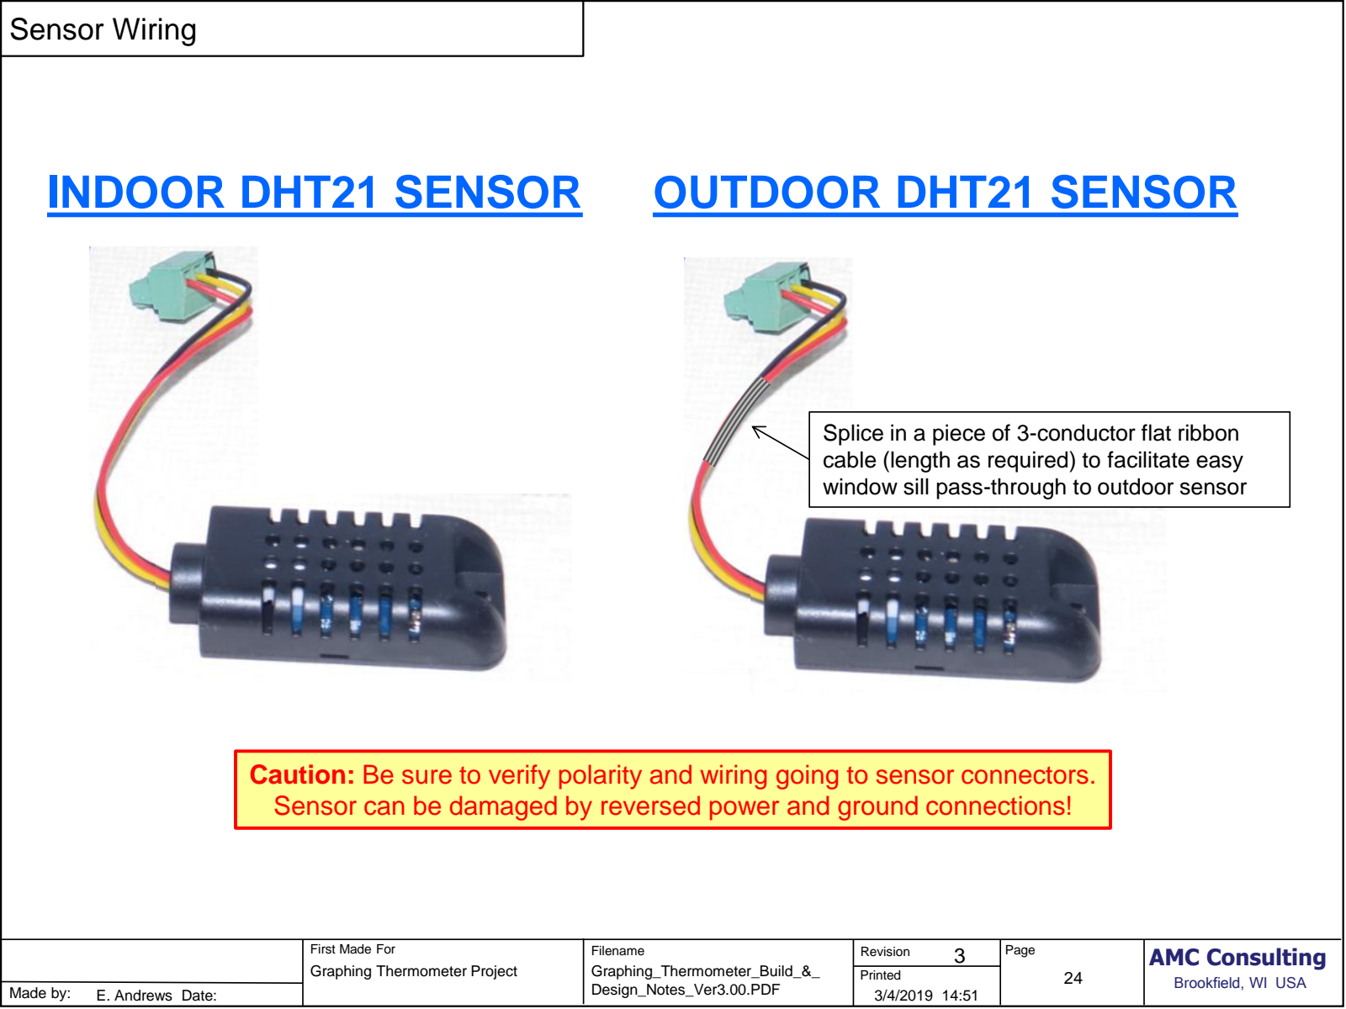
[picture p28: page 24]

# Splice in a piece of 3-conductor flat ribbon cable (length as required) to facilitate easy window sill pass-through to outdoor sensor

Caution: Be sure to verify polarity and wiring going to sensor connectors.

# Sensor can be damaged by reversed power and ground connections!

# LCD_CPU Sub-Assembly Guide

# LCD-CPU

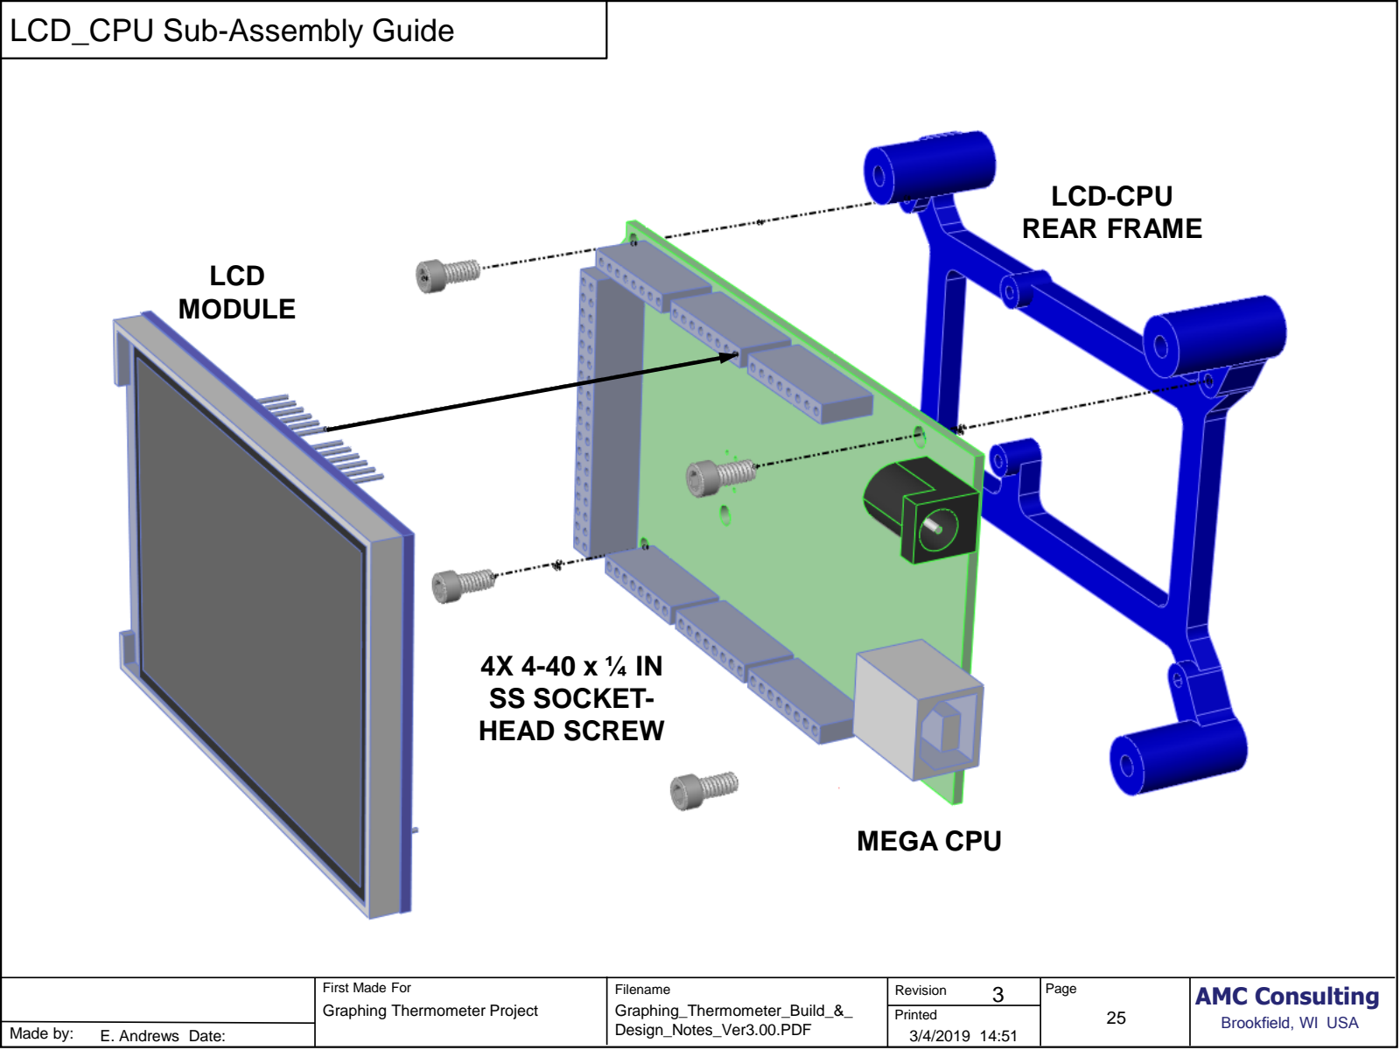
[picture p29: page 25]

# LCD MODULE

# MEGA CPU

# REAR FRAME

# 4X 4-40 x ¼ IN

# SS SOCKET-

# HEAD SCREW

# Front Panel Sub-Assembly Guide

# LCD-CPU

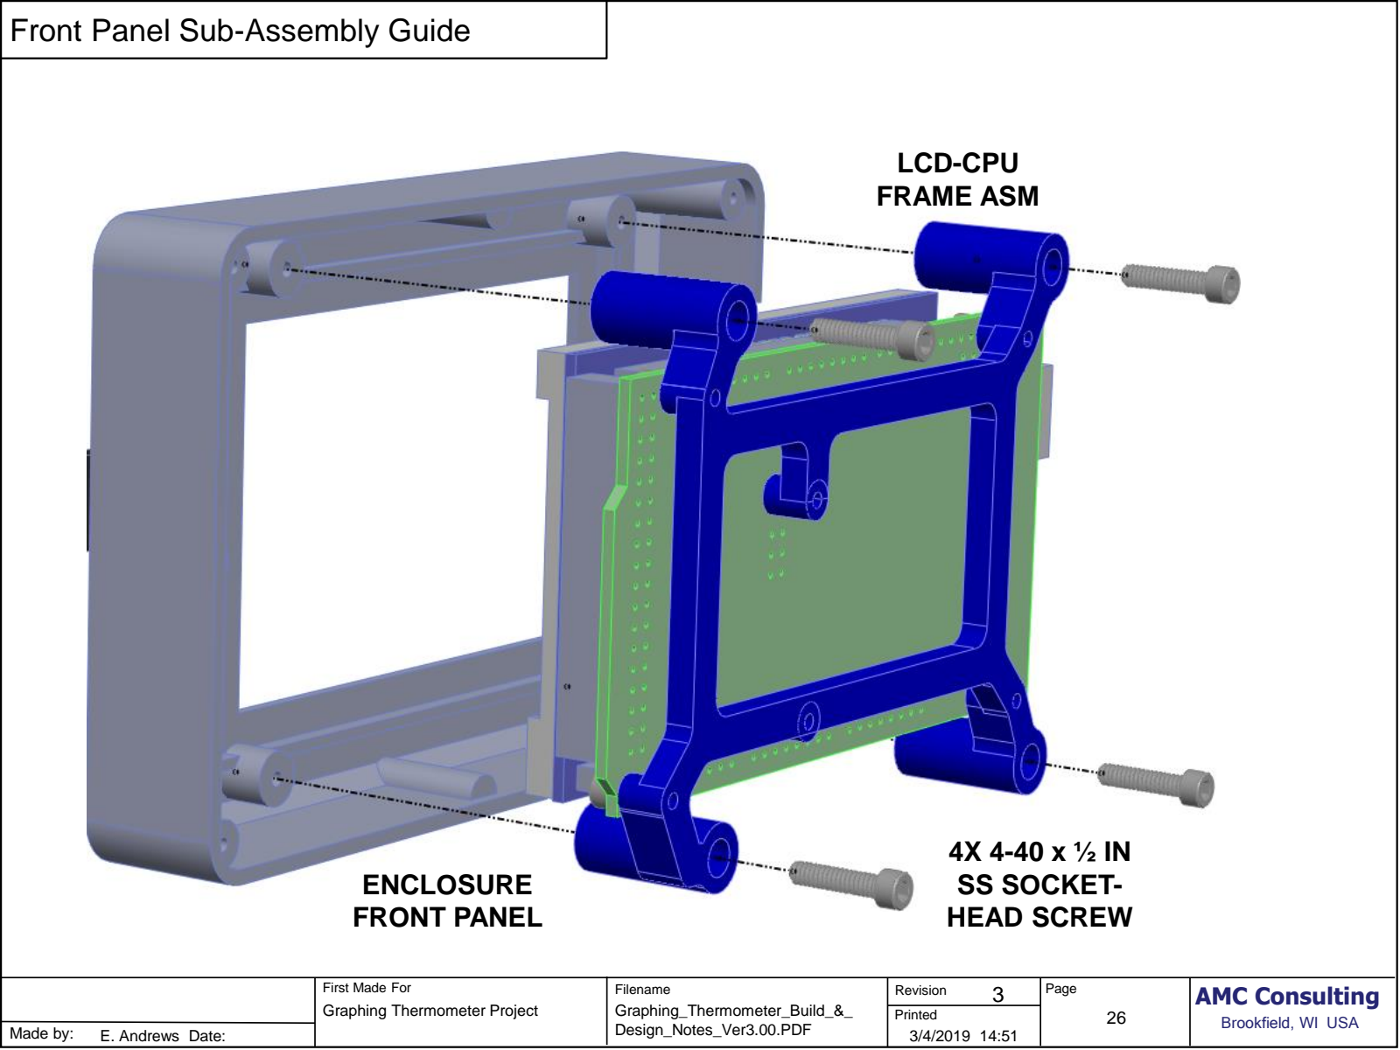
[picture p30: page 26]

# ENCLOSURE FRONT PANEL

# 4X 4-40 x ½ IN

# SS SOCKET-

# HEAD SCREW

# FRAME ASM

# Membrane Switch Assembly Guide

# BUTTON INSTALLATION

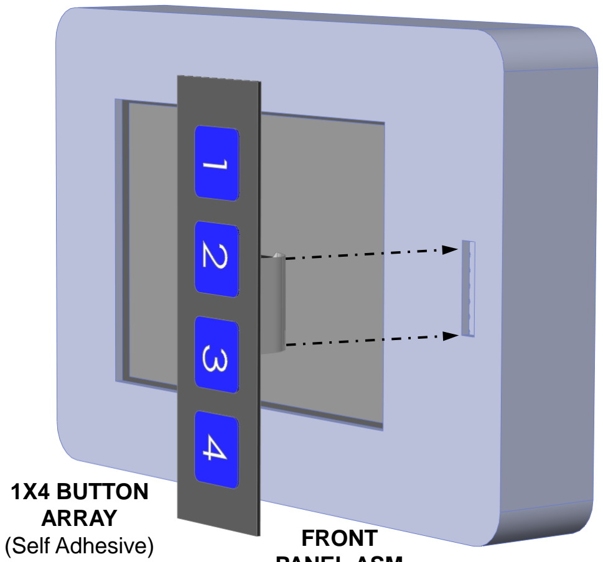
[picture p31: figure]
FRONT; 1X4 BUTTON ARRAY (Self Adhesive)

# PANEL ASM

# Rear Panel Assembly Guide

# 4X #4 X ¼ IN

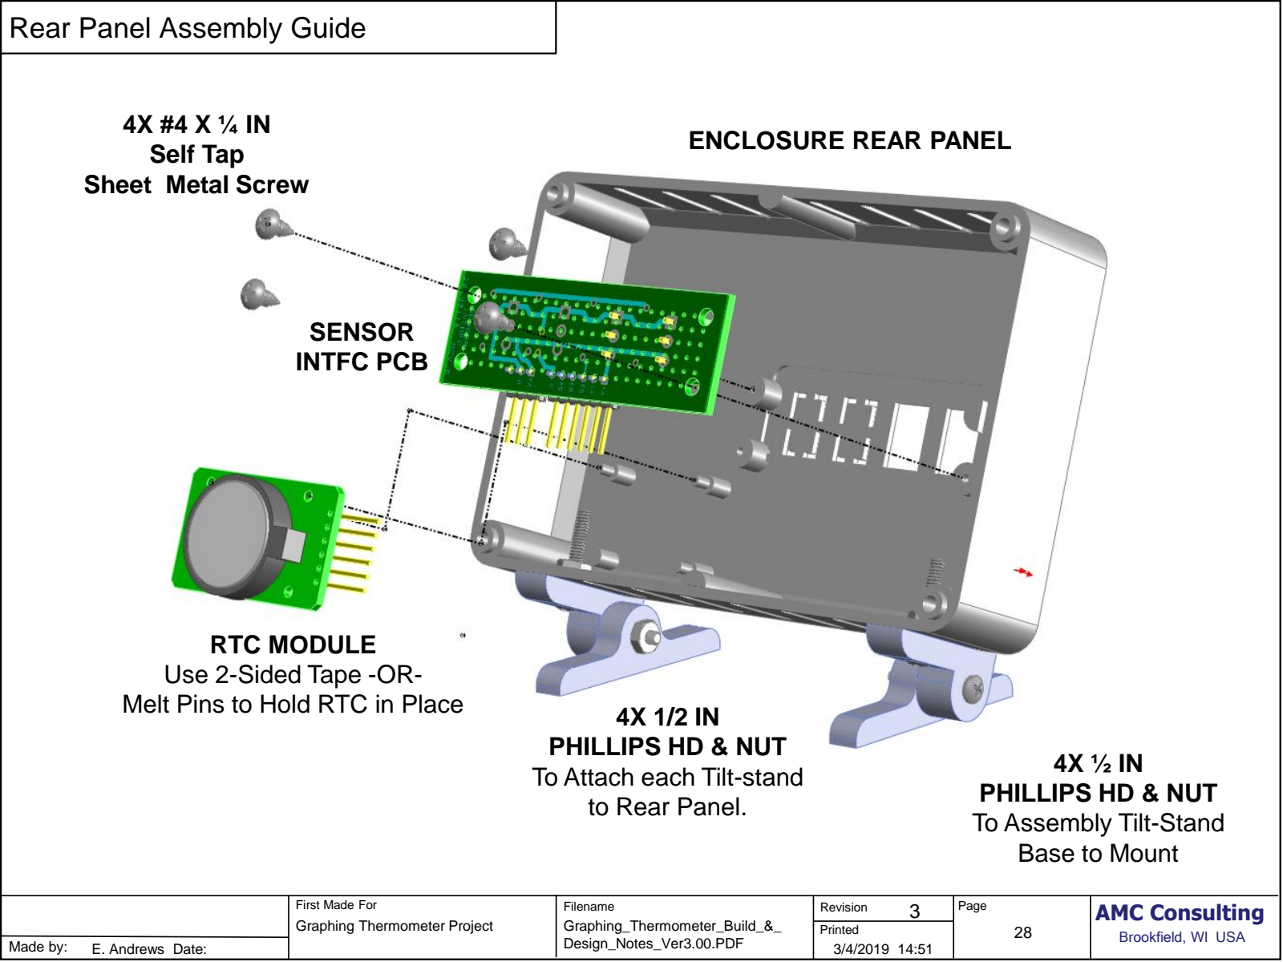
[picture p32: page 28]

# RTC MODULE Use 2-Sided Tape -OR-Melt Pins to Hold RTC in Place

# Self Tap Sheet Metal Screw

# ENCLOSURE REAR PANEL

# SENSOR INTFC PCB

# 4X 1/2 IN PHILLIPS HD & NUT To Attach each Tilt-stand

to Rear Panel.

# 4X ½ IN PHILLIPS HD & NUT To Assembly Tilt-Stand Base to Mount

# Wire Dress

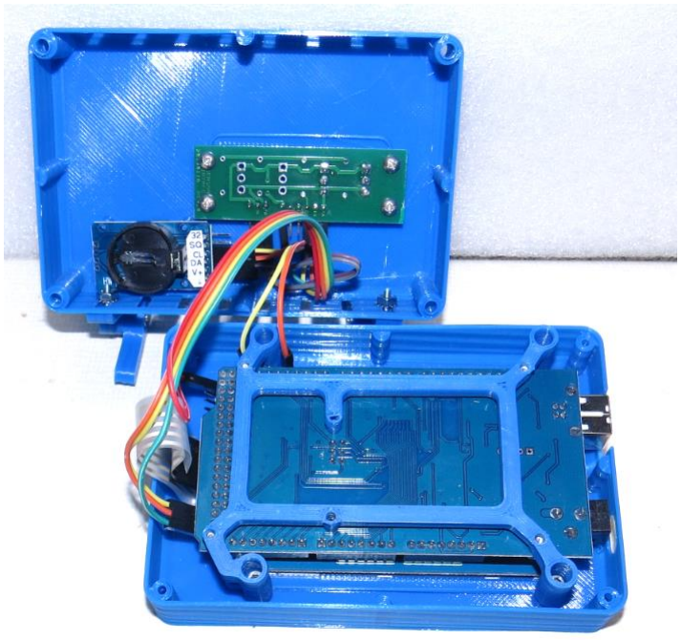
[picture p33: figure]

# Enclosure Final Assembly Guide

# FRONT

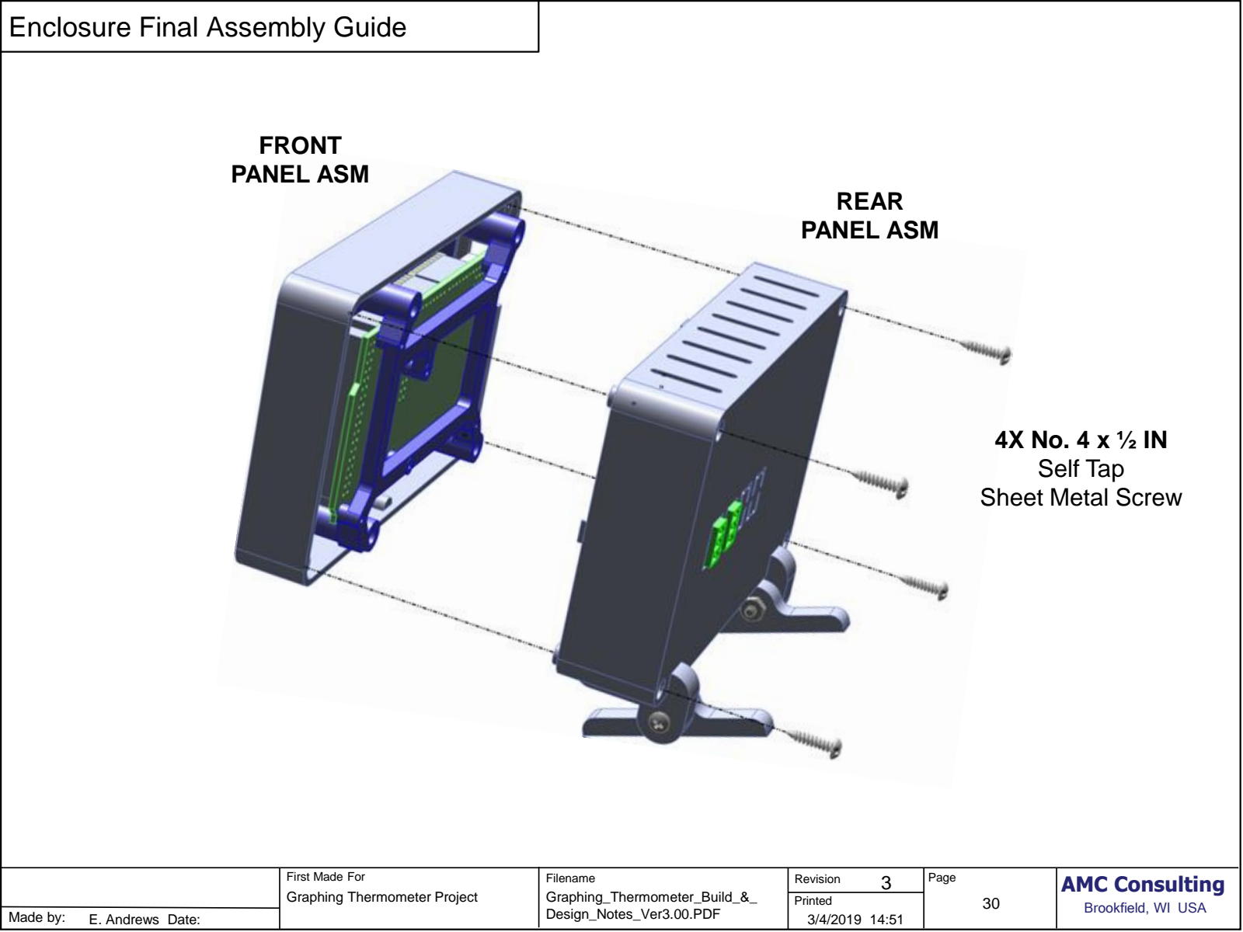
[picture p34: page 30]

# PANEL ASM REAR PANEL ASM

# 4X No. 4 x ½ IN Self Tap Sheet Metal Screw

# Software Libraries Needed

Ref# Include File Source Code Statement | Descripton/Installation Notes | Link
1 | GraphingThermometer.ino | Mainline Arduino Code for Project
| #include "droid_mono_40pt7b.h" | Included with item 1. Must be installed in the SAME
DIRECTORY as the mainline proggram.
2 | #include <Wire.h> | Part of IDE - No special installation needed
3 | #include <OneWire.h> | Part of IDE - No special installation needed
4 | #include <RTClib.h> | Download and install in "IDE library" | https://github.com/adafruit/RTClib
5 | #include <PString.h> | Download and install in "IDE library"
6 | #include <DHT.h> | Download and install in "IDE library" | https://github.com/adafruit/DHT-sensor-library
7 | #include <MCUFRIEND_kbv.h> | Download and install in "IDE library" | https://github.com/prenticedavid/MCUFRIEND_kbv
8 | #include <Bounce2.h> | Download and install in "IDE library" | https://github.com/thomasfredericks/Bounce2
9 | #include <Adafruit_GFX.h> | Download and install in "IDE library" | https://github.com/adafruit/Adafruit-GFX-Library
| #include <Fonts/FreeSans9pt7b.h> | Included with item 9
| #include <Fonts/FreeSans12pt7b.h> | Included with item 9
| #include <Fonts/FreeSerif12pt7b.h> | Included with item 9
| #include <Fonts/FreeMono24pt7b.h> | Included with item 9
| #include <Fonts/FreeSansBoldOblique24pt7b.h> | Included with item 9
| #include <Fonts/FreeSansBold24pt7b.h> | Included with item 9

## General Info for commonly available libraries: https://www.arduinolibraries.info/

## NOTES:

1. The Graphing Thermometer_Vx_xx.ino program was developed using Arduino IDE V 1.8.5. Program may need adjustments to compile on other IDE versions. The program was not tested on other versions of IDE.
2. You must download the program and install it into a directory of the same name on your PC. This directly must include:

## C:\...\Graphing_Thermometer_V3.10\Graphing_Thermometer_V3,10.ino C:\...\Graphing_Thermometer_V3.10\droid_mono_40pt7b.h

3. The following LIBRARIES indicated in the following table, items 2 through 9, must be installed into your IDE.
