Ed-EE-Eng/Graphics_Thermometer/extra/PCB_GerberFiles/Sensor_Interface_Board_Rev_0 - Schematic.pdf

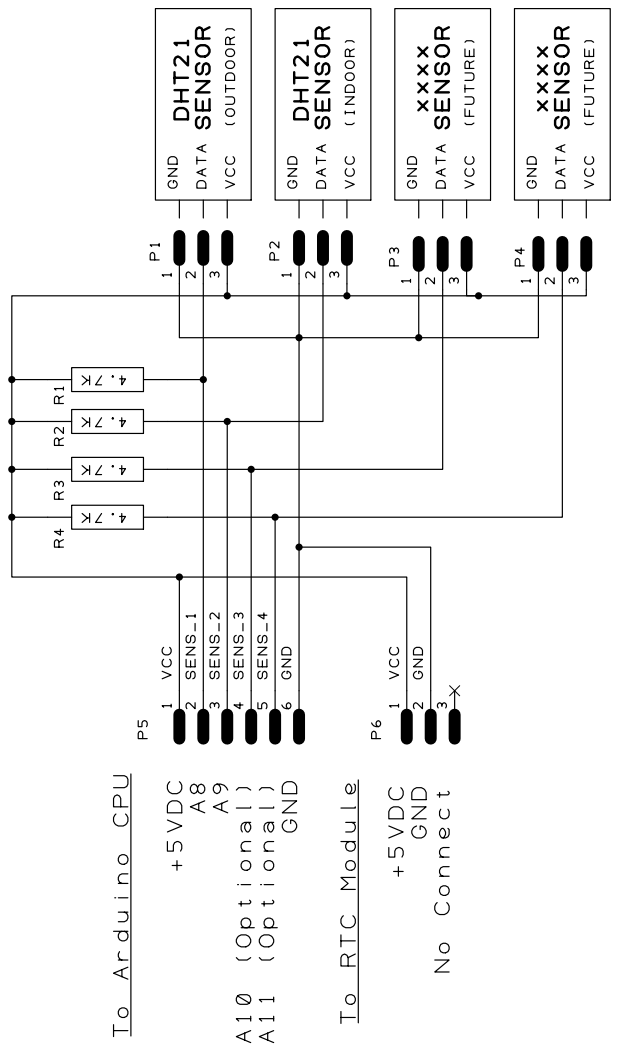
[picture p35: page 1]
