Ed-EE-Eng/Graphics_Thermometer/samples/Graphing_Thermometer_V3_10/droid_mono_40pt7b.h

const uint8_t droid_mono_40pt7bBitmaps[] PROGMEM = {
  0xFF, 0xFF, 0xFF, 0xFF, 0xFF, 0xFB, 0xF9, 0xFC, 0xFE, 0x7F, 0x3F, 0x9F,
  0xCF, 0xE7, 0xF3, 0xF9, 0xFC, 0xFE, 0x7F, 0x3F, 0x9F, 0xCF, 0xE7, 0xF3,
  0xF9, 0xFC, 0xFE, 0x7F, 0x3F, 0x8F, 0x87, 0xC3, 0xE1, 0xF0, 0xF8, 0x7C,
  0x3E, 0x1F, 0x0F, 0x87, 0xC3, 0xE1, 0xF0, 0xF8, 0x7C, 0x00, 0x00, 0x00,
  0x00, 0x00, 0x00, 0x00, 0xF8, 0xFE, 0xFF, 0xFF, 0xFF, 0xFF, 0xFF, 0xFF,
  0xFF, 0xFE, 0xFE, 0x3E, 0x00, 0xFF, 0x03, 0xFF, 0xF0, 0x1F, 0xFF, 0x80,
  0xFF, 0xFC, 0x07, 0xFF, 0xE0, 0x3F, 0xFF, 0x01, 0xFD, 0xF8, 0x0F, 0xEF,
  0xC0, 0x7F, 0x7E, 0x03, 0xFB, 0xF0, 0x0F, 0xDF, 0x80, 0x7C, 0xFC, 0x03,
  0xE7, 0xE0, 0x1F, 0x3F, 0x00, 0xF9, 0xF0, 0x07, 0xCF, 0x80, 0x3E, 0x7C,
  0x01, 0xF3, 0xE0, 0x0F, 0x9F, 0x00, 0x7C, 0x78, 0x03, 0xE0, 0x00, 0x00,
  0x7E, 0x00, 0x3F, 0x00, 0x00, 0x01, 0xF8, 0x00, 0xF8, 0x00, 0x00, 0x07,
  0xE0, 0x03, 0xE0, 0x00, 0x00, 0x1F, 0x00, 0x0F, 0x80, 0x00, 0x00, 0x7C,
  0x00, 0x7E, 0x00, 0x00, 0x03, 0xF0, 0x01, 0xF8, 0x00, 0x00, 0x0F, 0xC0,
  0x07, 0xC0, 0x00, 0x00, 0x3F, 0x00, 0x1F, 0x00, 0x00, 0x00, 0xF8, 0x00,
  0x7C, 0x00, 0x00, 0x03, 0xE0, 0x03, 0xF0, 0x00, 0x00, 0x1F, 0x80, 0x0F,
  0xC0, 0x00, 0x00, 0x7E, 0x00, 0x3F, 0x00, 0x00, 0x01, 0xF8, 0x00, 0xF8,
  0x00, 0x00, 0x07, 0xC0, 0x03, 0xE0, 0x00, 0x00, 0x1F, 0x00, 0x1F, 0x80,
  0x00, 0x00, 0xFC, 0x00, 0x7E, 0x00, 0x00, 0x03, 0xF0, 0x01, 0xF8, 0x00,
  0x7F, 0xFF, 0xFF, 0xFF, 0xFF, 0xF1, 0xFF, 0xFF, 0xFF, 0xFF, 0xFF, 0xC7,
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
  {  5349,  30,  58,  33,    1,  -56 },   // 0x3F '?'
  {  5567,  59,  63,  68,    4,  -55 } }; // 0x40 '@'

const GFXfont droid_mono_40pt7b PROGMEM = {
  (uint8_t  *)droid_mono_40pt7bBitmaps,
  (GFXglyph *)droid_mono_40pt7bGlyphs,
  0x20, 0x40, 91 };

// Approx. 6270 bytes
