Ed-EE-Eng/Graphics_Thermometer/(commit log)

2019-03-04 Initial Release
    Complete HW, SW, & 3-D Printed Enclosure for a Graphing Thermometer
    [480X320_MEGA_Front_Panel w4_Btn_Pad Rev2.STL, 480X320_MEGA_Front_Panel wNo_Btn_Pad Rev2.STL, 480x320 MEGA_Rear_Panel_Rev_3.STL, 480x320_Lcd_TiltStand2_Mount.STL, 480x320_Lcd_TiltStand4_Base (Threaded).STL, MEGA_Backside_Frame.STL]
2019-03-07 Update 480X320_MEGA_Front_Panel w4_Btn_Pad Rev2.STL
    Correct STL File Error.
    [480X320_MEGA_Front_Panel w4_Btn_Pad Rev2.STL]
